Akhmadi14/Terawang/Skematik desain/casing mainboard dan koper alat/tampak samping kanan kotak mainboard.jpg

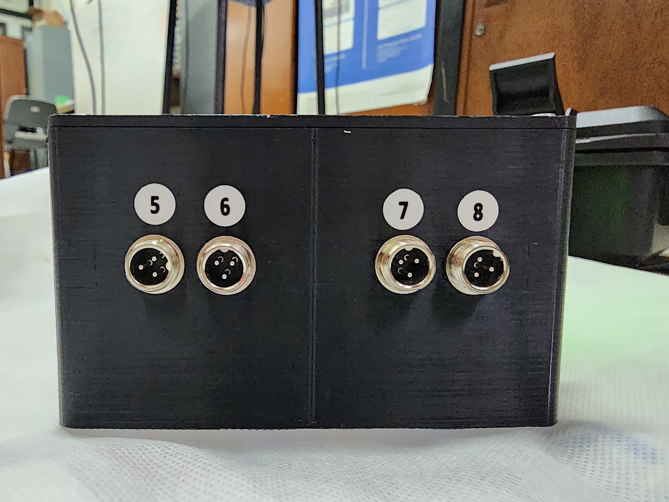
Skematik desain/casing mainboard dan koper alat/tampak samping kanan kotak mainboard.jpg
