Akhmadi14/Terawang/Dokumentasi/IMG_20250317_195810_024.jpg

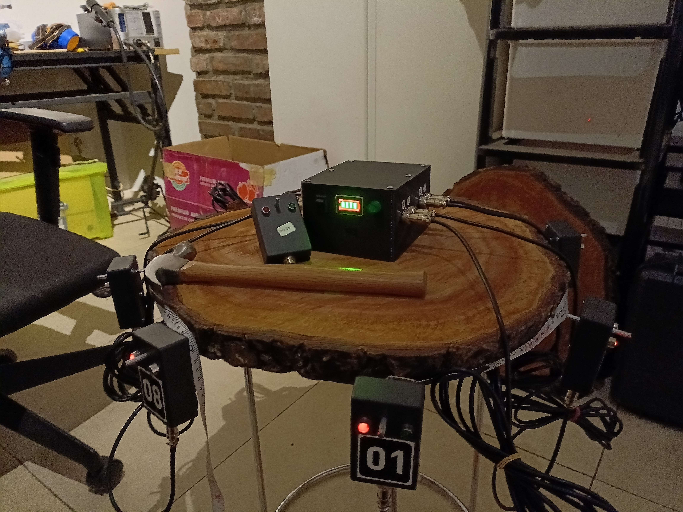
Dokumentasi/IMG_20250317_195810_024.jpg
