Akhmadi14/Terawang/README.md

# Terawang
Engineering Documents for project Terawang
