Akhmadi14/Terawang/Data/Versi_2/README.md

Perhitungan kecepatan dua dilakukan dengan memberikan kompensasi ToF di paku baja.

Penjelasan lebih mendetail bisa dilihat di file velocity_calc2.pdf
