Akhmadi14/Terawang/Data/2. MEDIA KAYU TREMBESI_26_NOV_2024.pdf

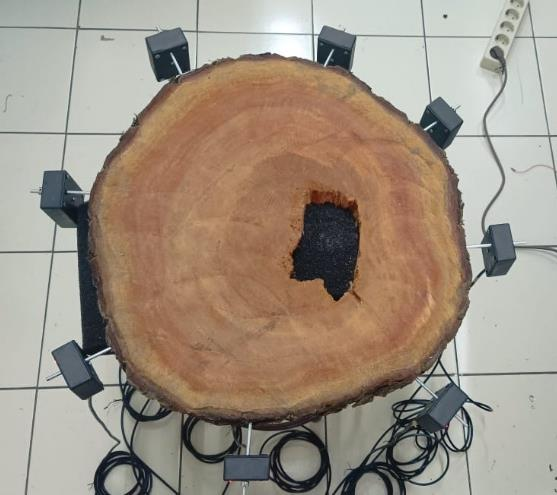
[picture p79: figure]

### PENGUJIAN DENGAN MEDIA UJI

Hari/Tgl | : Selasa, 26 November 2024
Jenis Kayu | : Trembesi
Diameter | : 49,8 cm
Keliling | : 156,7 cm
Keterangan | : -

### PERCOBAAN 1

### Kecepatan Rata-Rata (m/s)

### PERCOBAAN 2

### Kecepatan Rata-Rata (m/s)

### HASIL TOMOGRAFI PERCOBAAN 1

Sensor ke-n | v1 | v2 | v3 | v4 | v5 | v6 | v7 | v8
1 | # | 808 | 1245 | 1078 | 1149 | 797 | 1061 | 726
2 | 821 | # | 885 | 839 | 1110 | 452 | 952 | 942
3 | 1262 | 811 | # | 772 | 1065 | 317 | 987 | 1100
4 | 1622 | 600 | 1557 | # | 1334 | 584 | 1184 | 1322
5 | 1288 | 865 | 1286 | 952 | # | 276 | 955 | 980
6 | 1235 | 804 | 1488 | 1397 | 1310 | # | 1413 | 999
7 | 915 | 713 | 1081 | 862 | 898 | 218 | # | 697
8 | 1096 | 716 | 1404 | 547 | 1059 | 289 | 949 | #
Sensor ke-n | v1 | v2 | v3 | v4 | v5 | v6 | v7 | v8
1 | # | 837 | 1294 | 1220 | 1177 | 326 | 1165 | 686
2 | 861 | # | 898 | 926 | 1120 | 256 | 971 | 815
3 | 1265 | 836 | # | 774 | 1068 | 324 | 1025 | 773
4 | 1565 | 1147 | 1333 | # | 1153 | 261 | 1144 | 1209
5 | 1303 | 1104 | 1296 | 970 | # | 280 | 1027 | 947
6 | 1093 | 587 | 1239 | 1107 | 814 | # | 876 | 726
7 | 829 | 820 | 1091 | 827 | 933 | 200 | # | 675
8 | 1060 | 703 | 1375 | 507 | 1046 | 254 | 931 | #

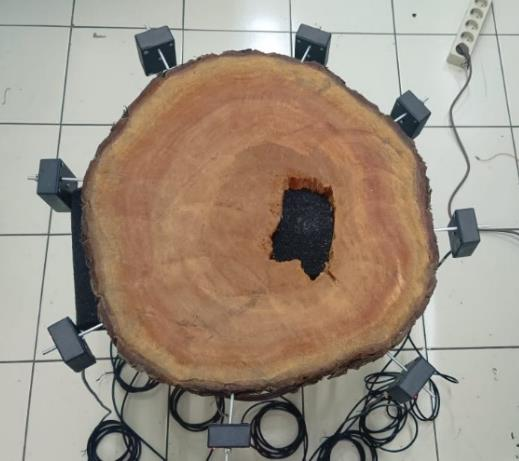
[picture p80: figure]
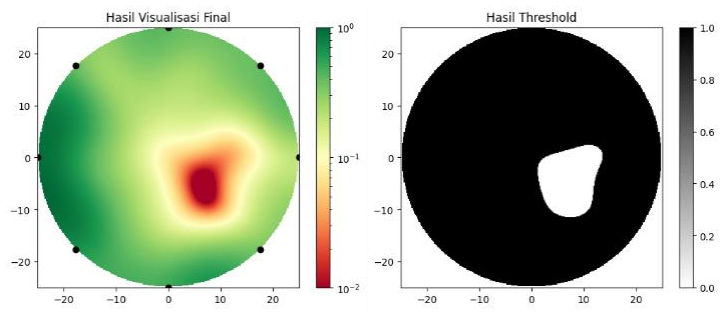
[picture p81: figure]
