Akhmadi14/Terawang/Data/3. POHON HIDUP1_19_DES_2024.pdf

## KAMIS, 19 DESEMBER 2024

Lokasi | : samping Pos Satpam Fakultas SBM

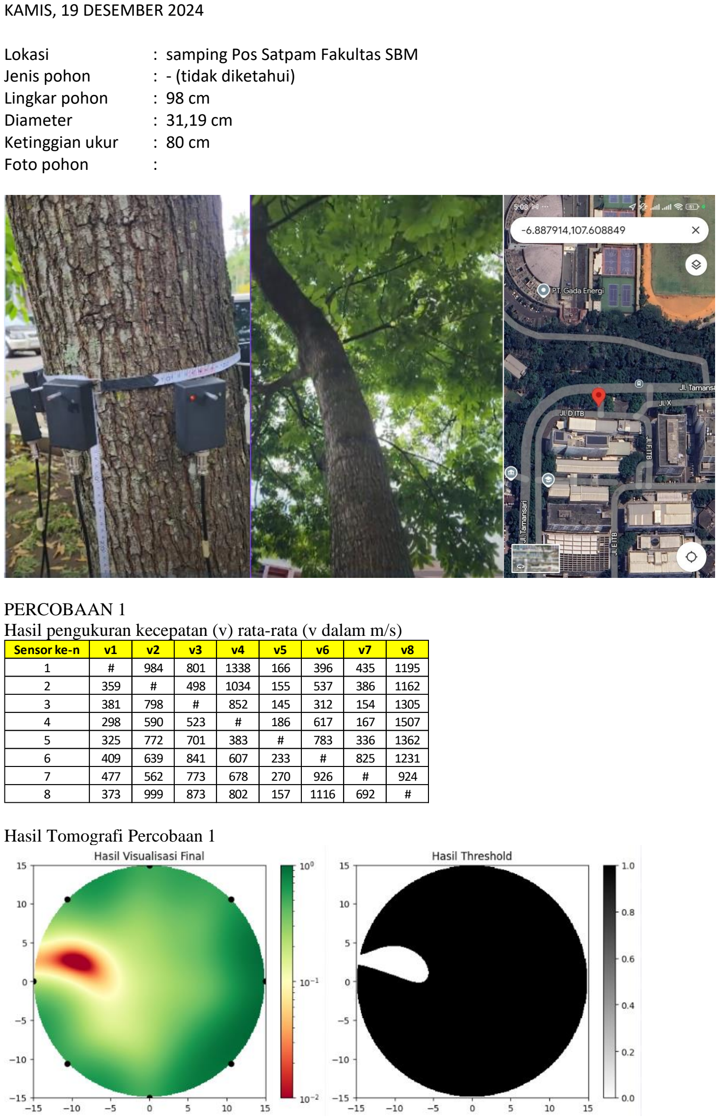
[picture p82: page 1]

Jenis pohon | : - (tidak diketahui)
Lingkar pohon | : 98 cm
Diameter | : 31,19 cm
Ketinggian ukur | : 80 cm
Foto pohon | :

### PERCOBAAN 1 Hasil pengukuran kecepatan (v) rata-rata (v dalam m/s)

### Hasil Tomografi Percobaan 1

Sensor ke-n | v1 | v2 | v3 | v4 | v5 | v6 | v7 | v8
1 | # | 984 | 801 | 1338 | 166 | 396 | 435 | 1195
2 | 359 | # | 498 | 1034 | 155 | 537 | 386 | 1162
3 | 381 | 798 | # | 852 | 145 | 312 | 154 | 1305
4 | 298 | 590 | 523 | # | 186 | 617 | 167 | 1507
5 | 325 | 772 | 701 | 383 | # | 783 | 336 | 1362
6 | 409 | 639 | 841 | 607 | 233 | # | 825 | 1231
7 | 477 | 562 | 773 | 678 | 270 | 926 | # | 924
8 | 373 | 999 | 873 | 802 | 157 | 1116 | 692 | #

### PERCOBAAN 2 Hasil pengukuran kecepatan (v) rata-rata (v dalam m/s)

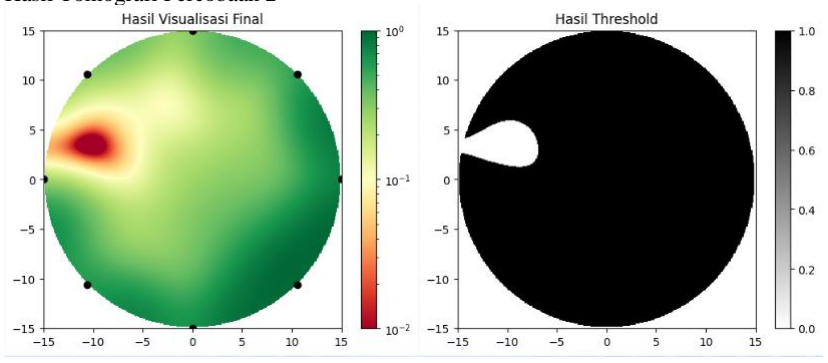
[picture p83: figure]

### Hasil Tomografi Percobaan 2

Sensor ke-n | v1 | v2 | v3 | v4 | v5 | v6 | v7 | v8
1 | # | 897 | 329 | 291 | 166 | 394 | 421 | 1013
2 | 361 | # | 493 | 435 | 103 | 543 | 387 | 1156
3 | 379 | 711 | # | 398 | 147 | 258 | 249 | 1267
4 | 188 | 460 | 495 | # | 82 | 290 | 138 | 1322
5 | 329 | 774 | 700 | 349 | # | 779 | 355 | 1336
6 | 396 | 389 | 691 | 371 | 171 | # | 791 | 1177
7 | 471 | 677 | 345 | 423 | 298 | 898 | # | 906
8 | 374 | 1005 | 613 | 760 | 94 | 1123 | 576 | #
