Akhmadi14/Terawang/Data/4. POHON HIDUP2_19_DES_2024.pdf

## KAMIS, 19 DESEMBER 2024

Lokasi | : belakang gedung fakultas Teknik Mesin

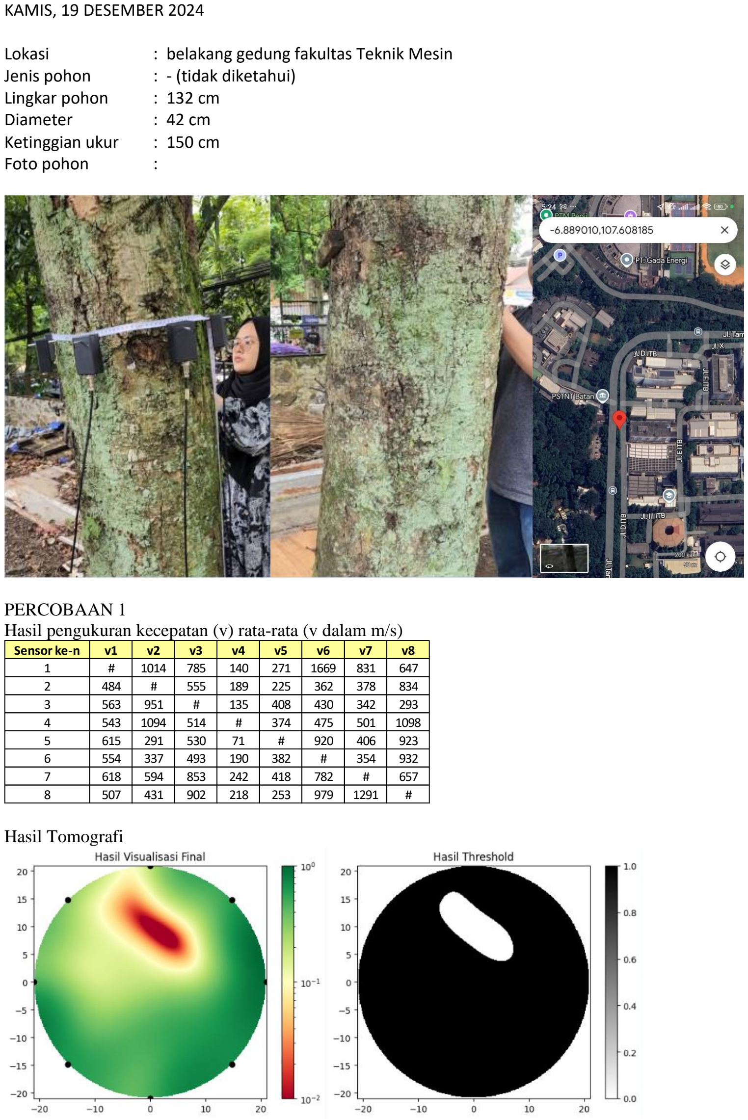
[picture p84: page 1]

Jenis pohon | : - (tidak diketahui)
Lingkar pohon | : 132 cm
Diameter | : 42 cm
Ketinggian ukur | : 150 cm
Foto pohon | :

### PERCOBAAN 1 Hasil pengukuran kecepatan (v) rata-rata (v dalam m/s)

### Hasil Tomografi

Sensor ke-n | v1 | v2 | v3 | v4 | v5 | v6 | v7 | v8
1 | # | 1014 | 785 | 140 | 271 | 1669 | 831 | 647
2 | 484 | # | 555 | 189 | 225 | 362 | 378 | 834
3 | 563 | 951 | # | 135 | 408 | 430 | 342 | 293
4 | 543 | 1094 | 514 | # | 374 | 475 | 501 | 1098
5 | 615 | 291 | 530 | 71 | # | 920 | 406 | 923
6 | 554 | 337 | 493 | 190 | 382 | # | 354 | 932
7 | 618 | 594 | 853 | 242 | 418 | 782 | # | 657
8 | 507 | 431 | 902 | 218 | 253 | 979 | 1291 | #
