Akhmadi14/Terawang/Data/5. POHON HIDUP3_7_JAN_2025.pdf

## SELASA, 7 JANUARI 2025

Lokasi | : Depan Labtek XVII

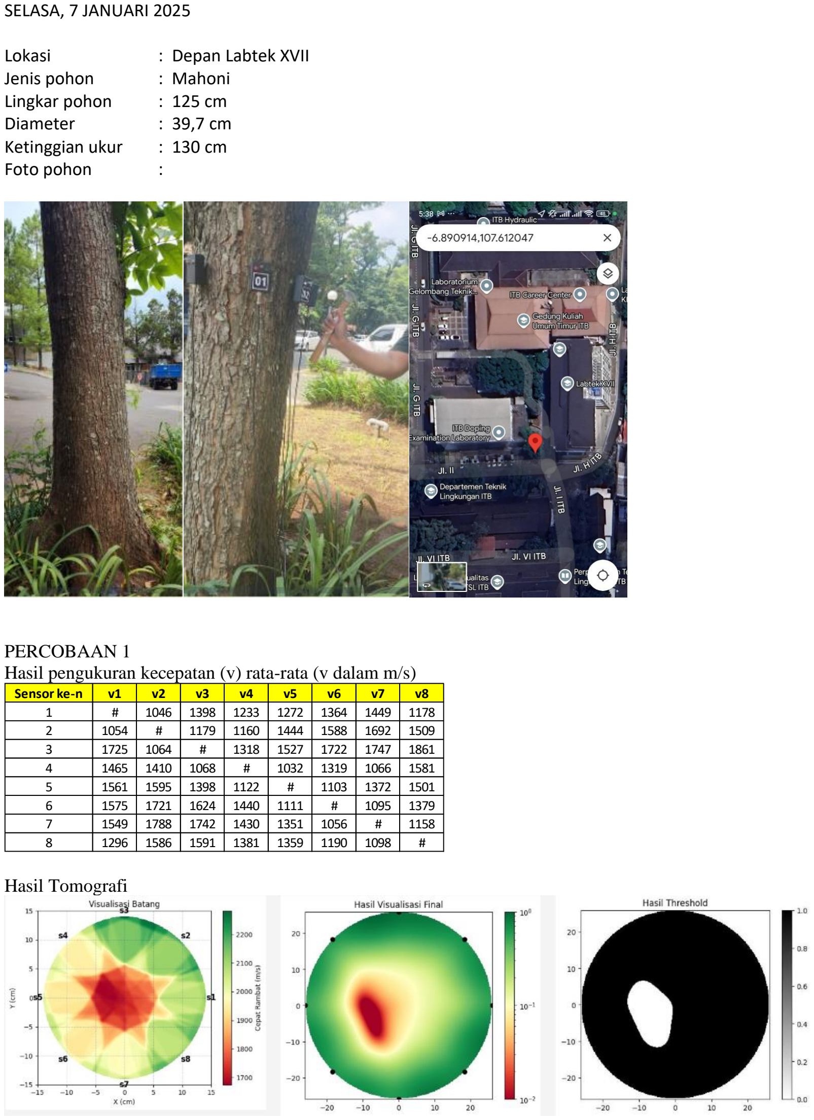
[picture p85: page 1]

Jenis pohon | : Mahoni
Lingkar pohon | : 125 cm
Diameter | : 39,7 cm
Ketinggian ukur | : 130 cm
Foto pohon | :

### PERCOBAAN 1 Hasil pengukuran kecepatan (v) rata-rata (v dalam m/s)

### Hasil Tomografi

Sensor ke-n | v1 | v2 | v3 | v4 | v5 | v6 | v7 | v8
1 | # | 1046 | 1398 | 1233 | 1272 | 1364 | 1449 | 1178
2 | 1054 | # | 1179 | 1160 | 1444 | 1588 | 1692 | 1509
3 | 1725 | 1064 | # | 1318 | 1527 | 1722 | 1747 | 1861
4 | 1465 | 1410 | 1068 | # | 1032 | 1319 | 1066 | 1581
5 | 1561 | 1595 | 1398 | 1122 | # | 1103 | 1372 | 1501
6 | 1575 | 1721 | 1624 | 1440 | 1111 | # | 1095 | 1379
7 | 1549 | 1788 | 1742 | 1430 | 1351 | 1056 | # | 1158
8 | 1296 | 1586 | 1591 | 1381 | 1359 | 1190 | 1098 | #
