Akhmadi14/Terawang/Video/Pengujian/README.md

Video Pengujian di pohon menggunakan Terawang

Video Pengujian berupa link Youtube.
