Akhmadi14/Terawang/Dokumentasi/IMG_20250319_092220_522.jpg

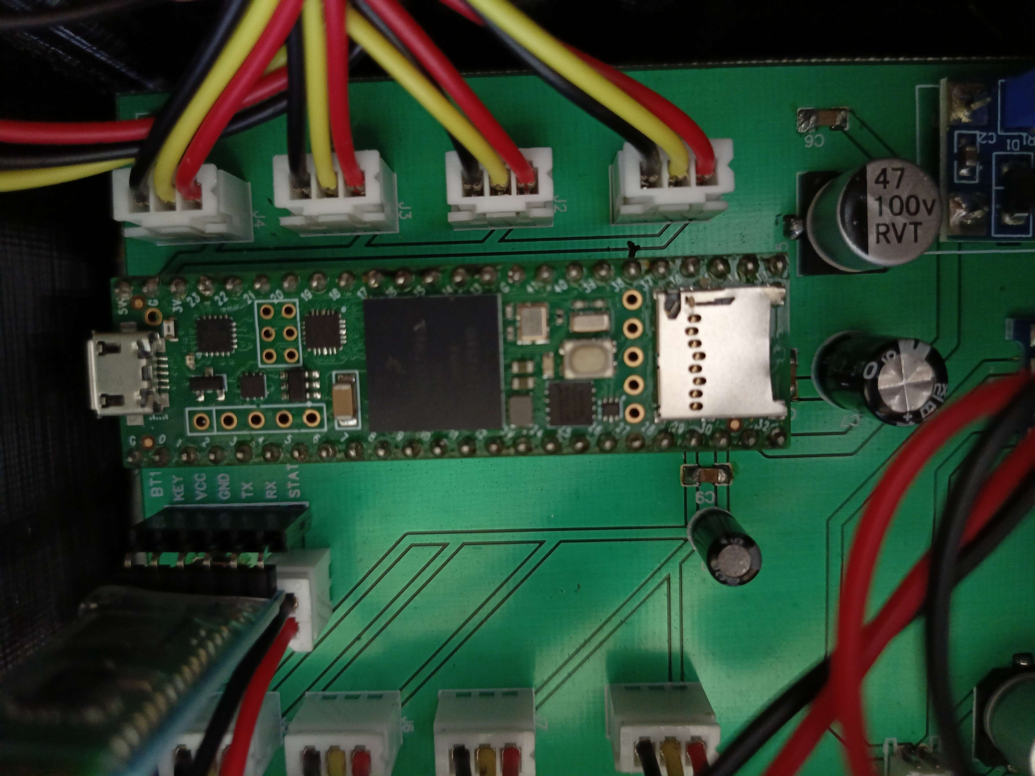
Dokumentasi/IMG_20250319_092220_522.jpg
