Akhmadi14/Terawang/Dokumentasi/IMG_20250319_092229_414.jpg

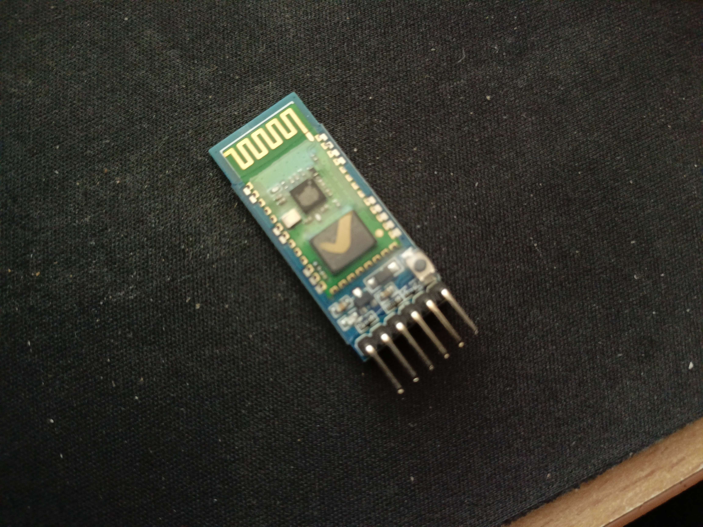
Dokumentasi/IMG_20250319_092229_414.jpg
