Akhmadi14/Terawang/Dokumentasi/IMG_20250319_100055_708.jpg

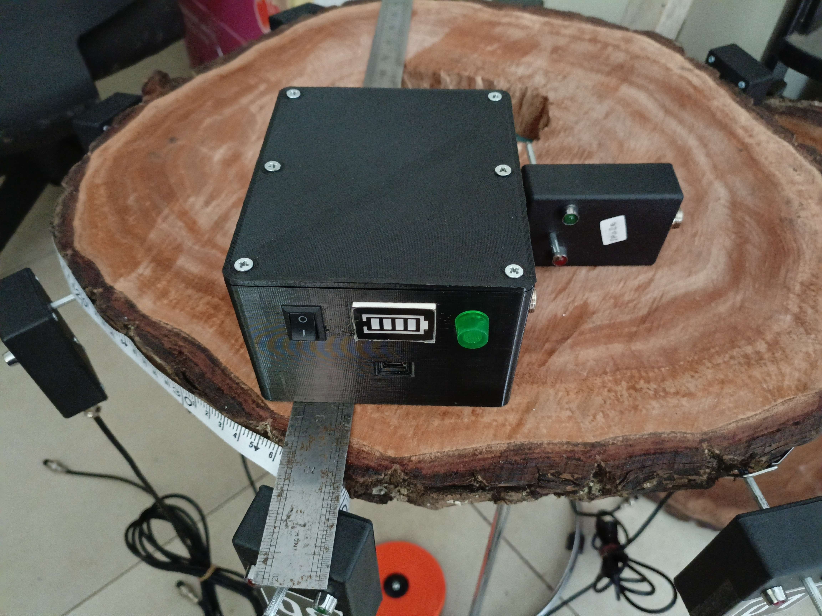
Dokumentasi/IMG_20250319_100055_708.jpg
