Akhmadi14/Terawang/Dokumentasi/WhatsApp Image 2025-03-20 at 09.49.11_72c5101f.jpg

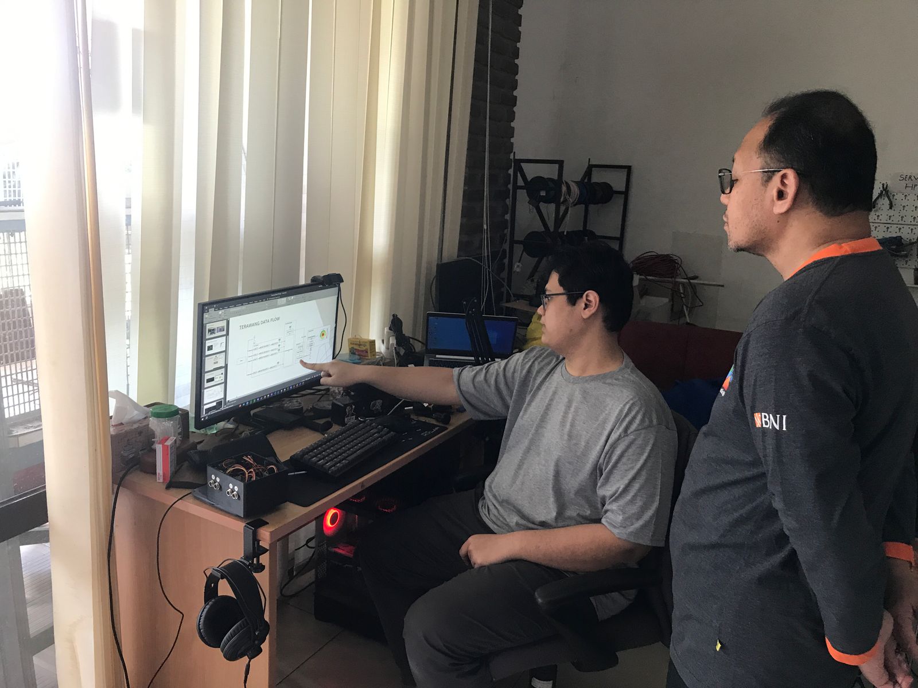
Dokumentasi/WhatsApp Image 2025-03-20 at 09.49.11_72c5101f.jpg
