Akhmadi14/Terawang/Hasil pengukuran/250108/a.png

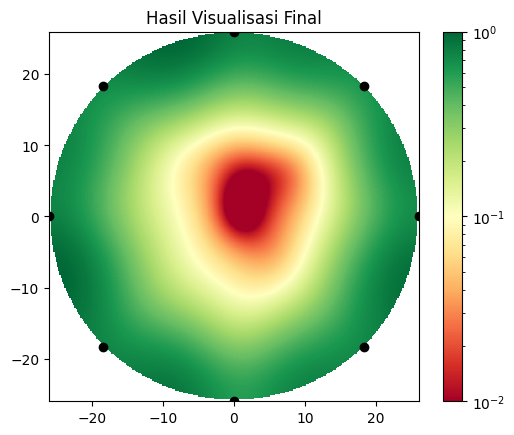
Hasil pengukuran/250108/a.png
