Akhmadi14/Terawang/Hasil pengukuran/250108/b.png

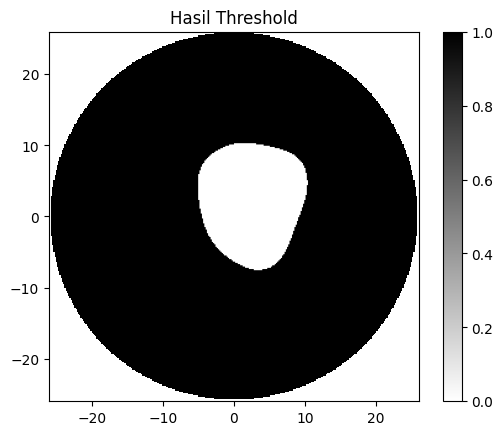
Hasil pengukuran/250108/b.png
