Akhmadi14/Terawang/Hasil pengukuran/pengukuran 1.1/final 1.1.png

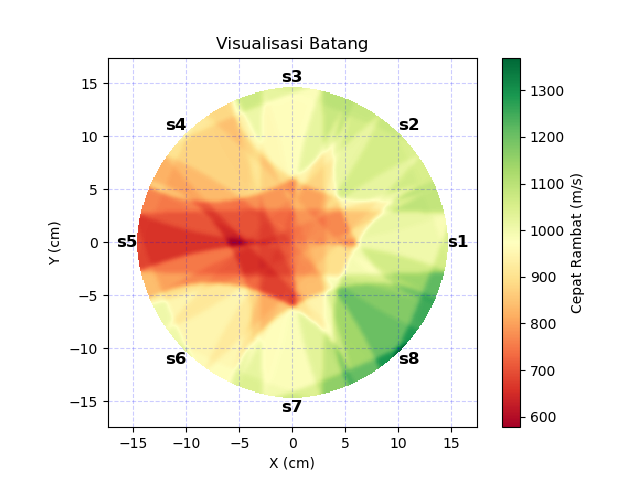
Hasil pengukuran/pengukuran 1.1/final 1.1.png
