Akhmadi14/Terawang/Hasil pengukuran/pengukuran 1.1/th_1.1.png

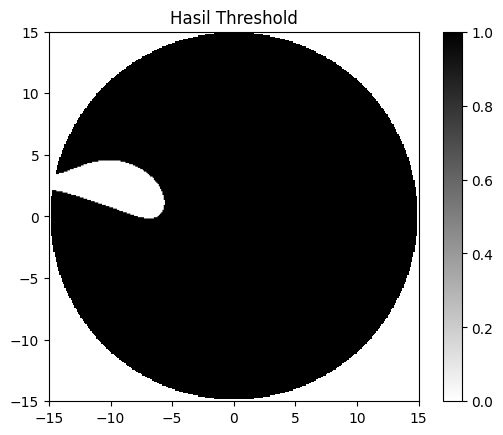
Hasil pengukuran/pengukuran 1.1/th_1.1.png
