Akhmadi14/Terawang/Hasil pengukuran/pengukuran 1.1/visual_1.1.png

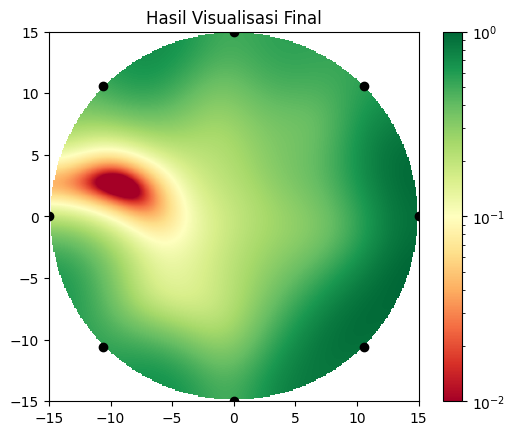
Hasil pengukuran/pengukuran 1.1/visual_1.1.png
