Akhmadi14/Terawang/Hasil pengukuran/pengukuran 1.2/visual_1.2.png

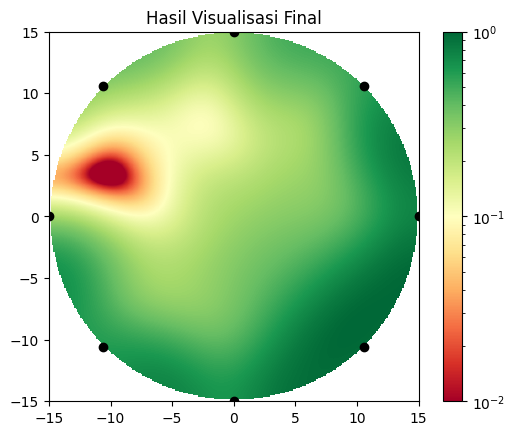
Hasil pengukuran/pengukuran 1.2/visual_1.2.png
