Akhmadi14/Terawang/Hasil pengukuran/pengukuran 2/final 2.png

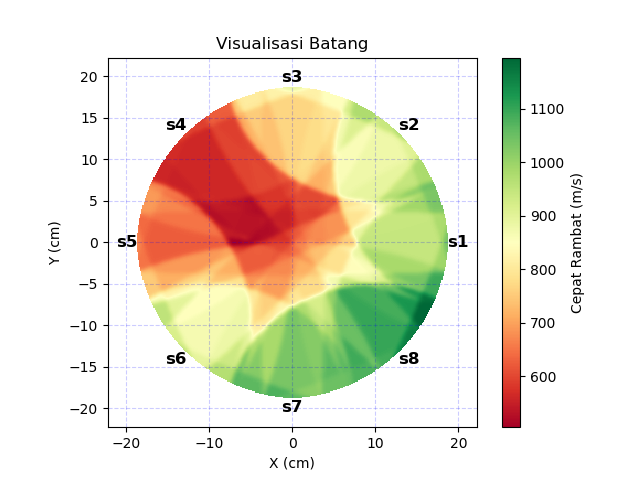
Hasil pengukuran/pengukuran 2/final 2.png
