Akhmadi14/Terawang/Hasil pengukuran/pengukuran 2/th_2.png

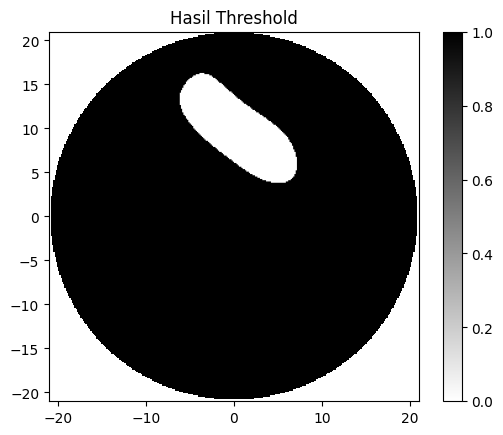
Hasil pengukuran/pengukuran 2/th_2.png
