Akhmadi14/Terawang/Hasil pengukuran/pengukuran 2/visual_2.png

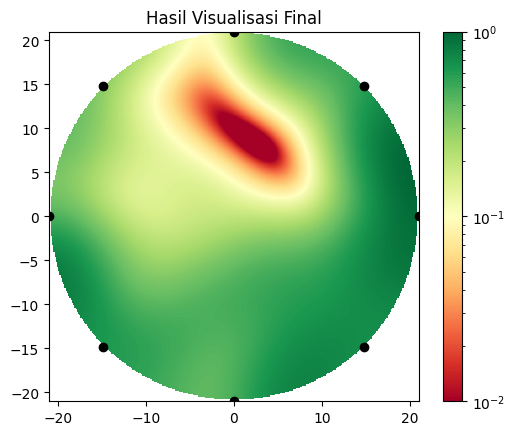
Hasil pengukuran/pengukuran 2/visual_2.png
