Akhmadi14/Terawang/Hasil pengukuran/pengukuran 2/viusal_pohon_basah.png

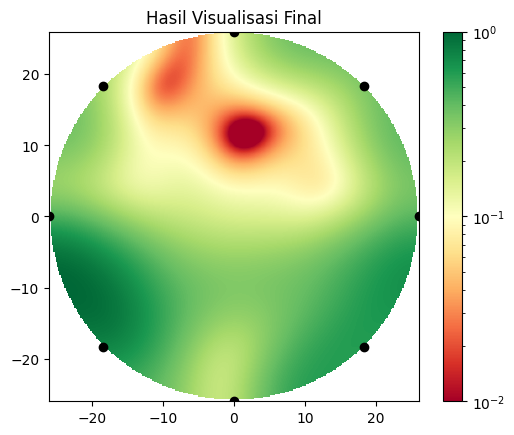
Hasil pengukuran/pengukuran 2/viusal_pohon_basah.png
