Akhmadi14/Terawang/Hasil pengukuran/pengukuran basah/final basah.png

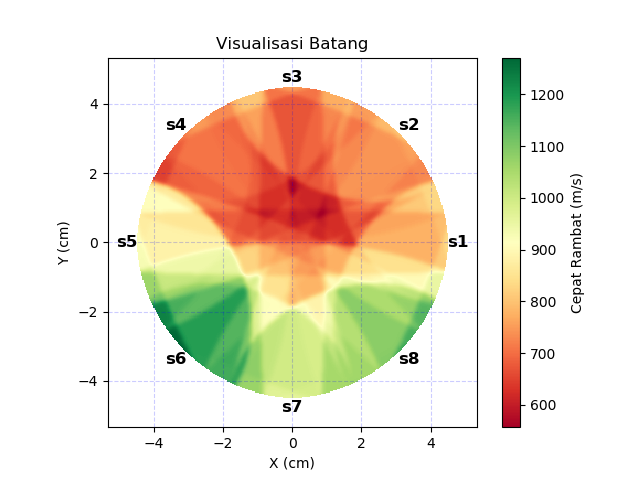
Hasil pengukuran/pengukuran basah/final basah.png
