Akhmadi14/Terawang/Hasil pengukuran/pengukuran basah/LINE_ALBUM_Hasil Pengukuran Pohon Basah 20241220_241226_1.jpg

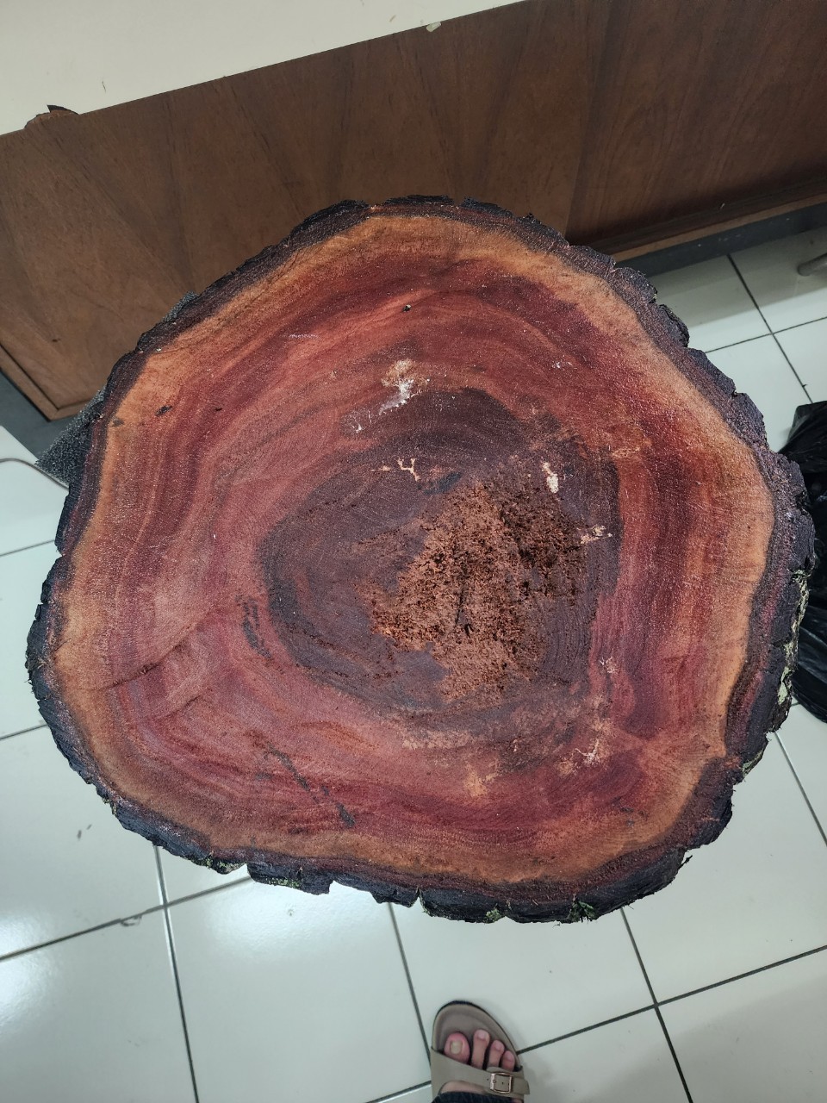
Hasil pengukuran/pengukuran basah/LINE_ALBUM_Hasil Pengukuran Pohon Basah 20241220_241226_1.jpg
