Akhmadi14/Terawang/Hasil pengukuran/pengukuran kering 2/404a2349-3994-4f09-90e3-6211c54b1446.jpg

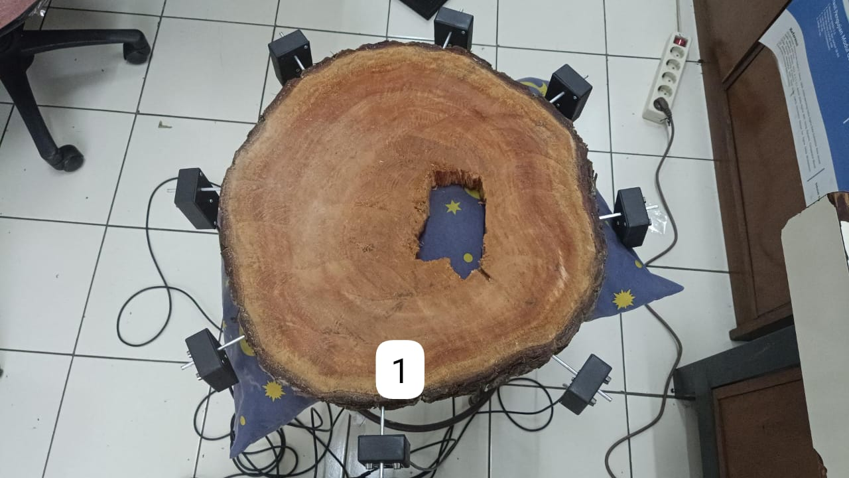
Hasil pengukuran/pengukuran kering 2/404a2349-3994-4f09-90e3-6211c54b1446.jpg
