Akhmadi14/Terawang/Hasil pengukuran/pengukuran kering/final kering.png

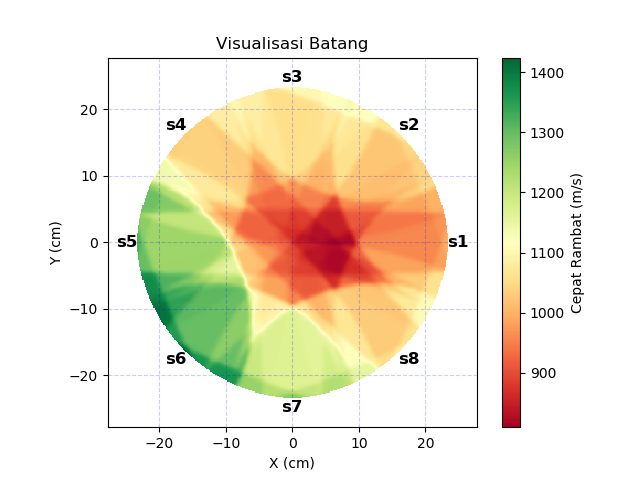
Hasil pengukuran/pengukuran kering/final kering.png
