Akhmadi14/Terawang/Hasil pengukuran/pengukuran kering/LINE_ALBUM_Pohon Kering (sensitivitas lebih tinggi) 20241220_241226_1.jpg

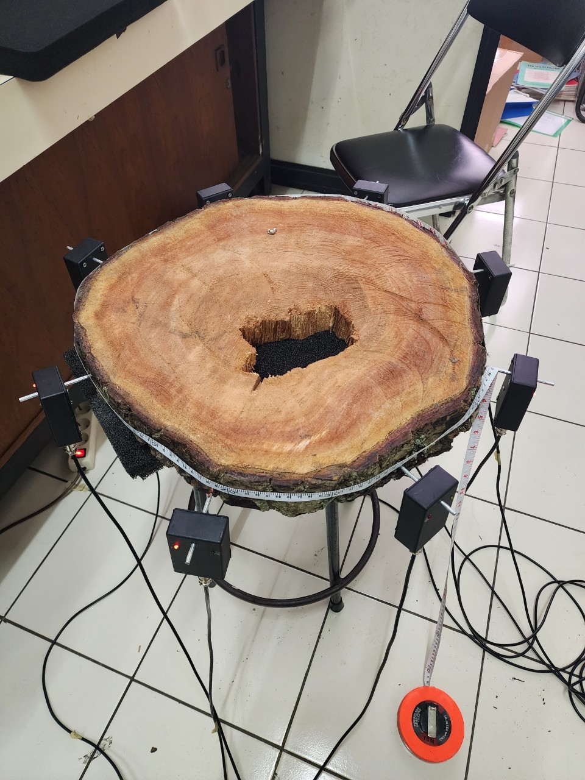
Hasil pengukuran/pengukuran kering/LINE_ALBUM_Pohon Kering (sensitivitas lebih tinggi) 20241220_241226_1.jpg
