Akhmadi14/Terawang/Hasil pengukuran/pengukuran kering/th_kering.png

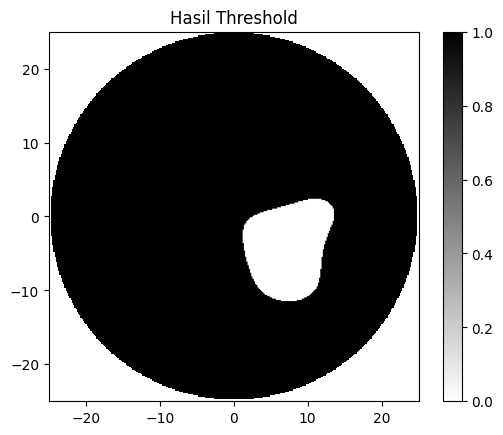
Hasil pengukuran/pengukuran kering/th_kering.png
