Akhmadi14/Terawang/Hasil pengukuran/pengukuran kering/visual_kering.png

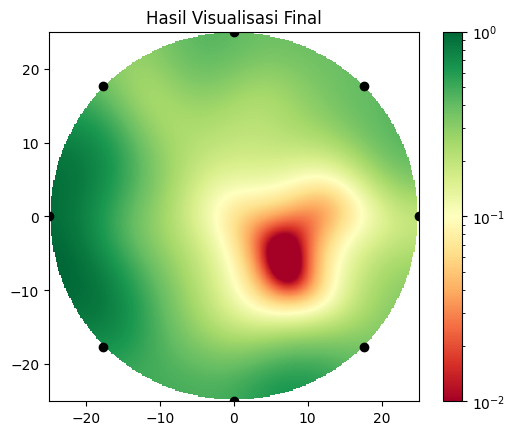
Hasil pengukuran/pengukuran kering/visual_kering.png
