Akhmadi14/Terawang/Hasil pengukuran/pengukuran mahoni gkut/a.png

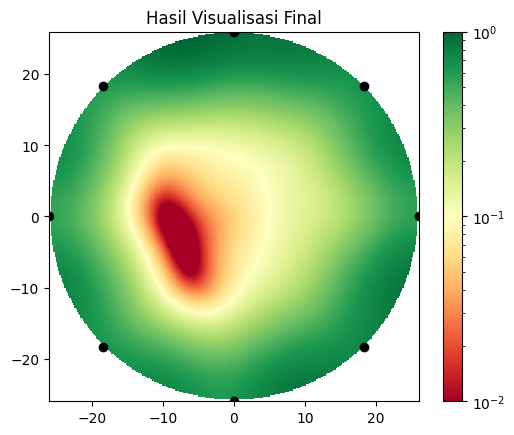
Hasil pengukuran/pengukuran mahoni gkut/a.png
