Akhmadi14/Terawang/Hasil pengukuran/pengukuran mahoni gkut/b.png

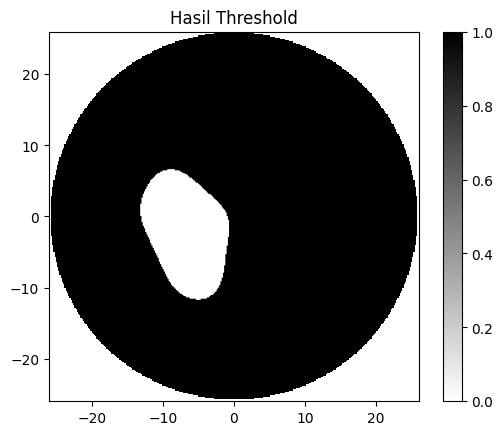
Hasil pengukuran/pengukuran mahoni gkut/b.png
