Akhmadi14/Terawang/Hasil pengukuran/pengukuran mahoni gkut/hasil pengukuran.png

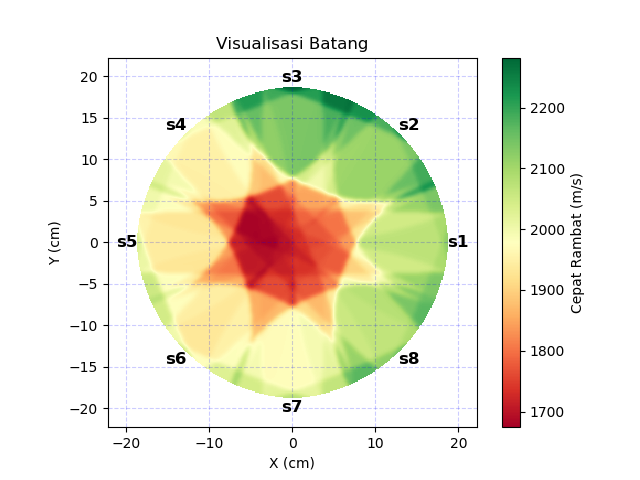
Hasil pengukuran/pengukuran mahoni gkut/hasil pengukuran.png
