Akhmadi14/Terawang/Skematik desain/Arsitektur Utama.png

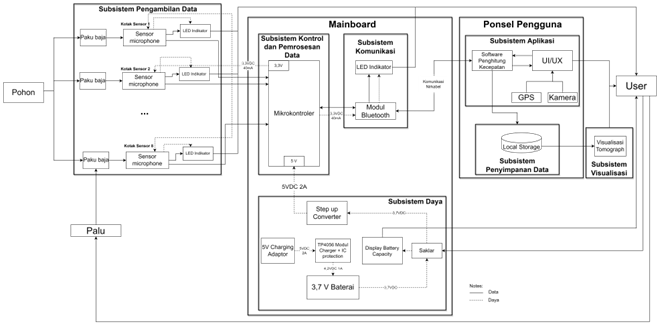
Skematik desain/Arsitektur Utama.png
