Akhmadi14/Terawang/Skematik desain/casing mainboard dan koper alat/cara pemasangan.jpg

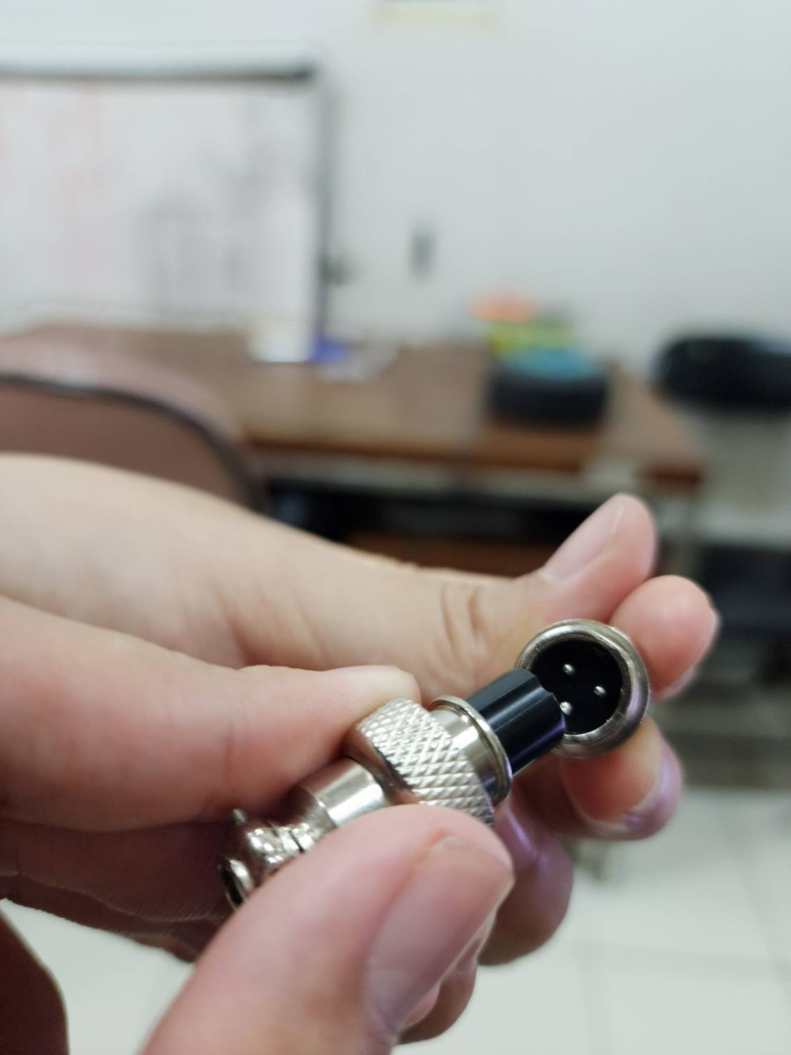
Skematik desain/casing mainboard dan koper alat/cara pemasangan.jpg
