Akhmadi14/Terawang/Skematik desain/casing mainboard dan koper alat/Desain kotak mainboard(isometri).png

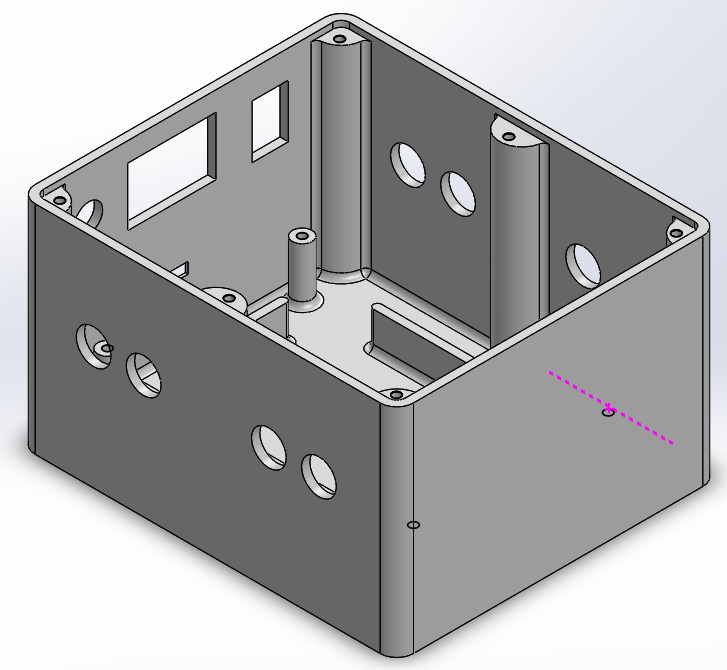
Skematik desain/casing mainboard dan koper alat/Desain kotak mainboard(isometri).png
