Akhmadi14/Terawang/Skematik desain/casing mainboard dan koper alat/hasil modifikasi luggage box1.jpg

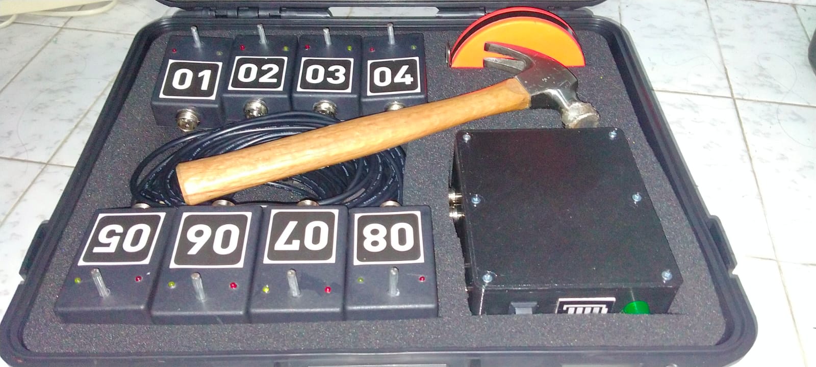
Skematik desain/casing mainboard dan koper alat/hasil modifikasi luggage box1.jpg
