Akhmadi14/Terawang/Skematik desain/casing mainboard dan koper alat/koper alat(Luggage box).png

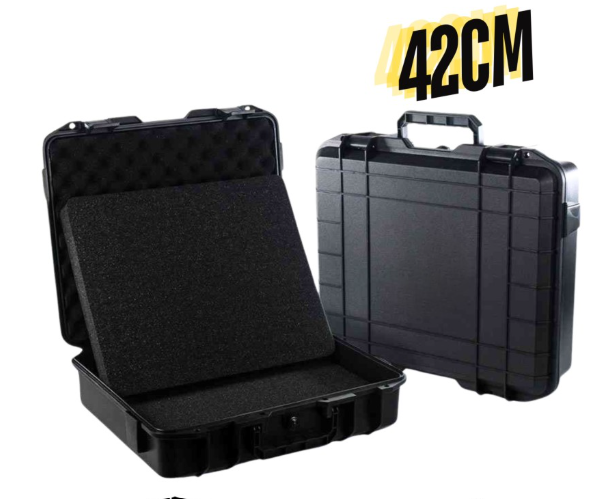
Skematik desain/casing mainboard dan koper alat/koper alat(Luggage box).png
