Akhmadi14/Terawang/Skematik desain/casing mainboard dan koper alat/port kotak mainboard dengan kabel.jpg

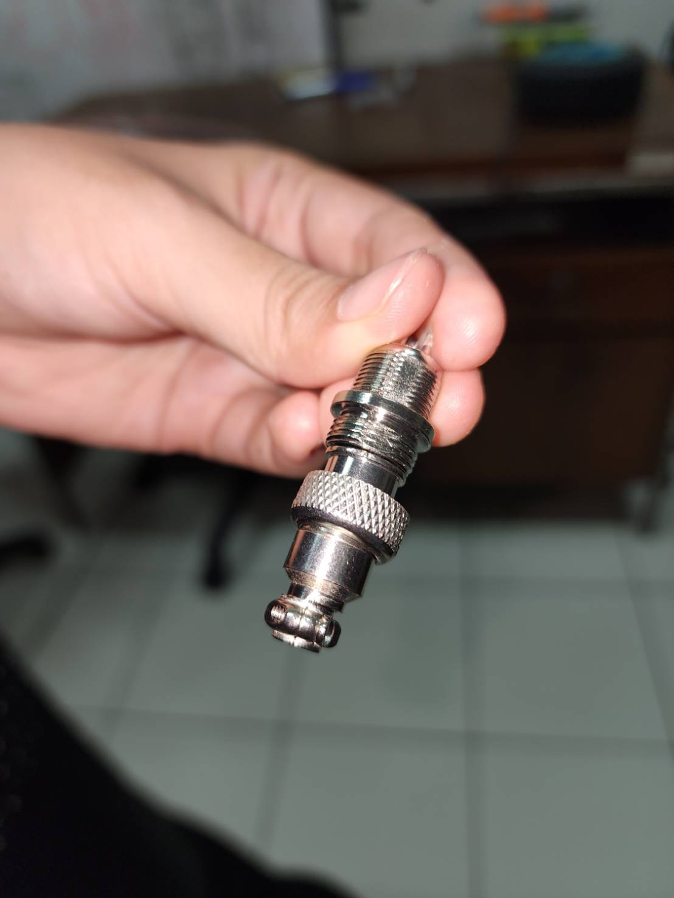
Skematik desain/casing mainboard dan koper alat/port kotak mainboard dengan kabel.jpg
