Akhmadi14/Terawang/Skematik desain/casing mainboard dan koper alat/tampak depan casing mainboard.jpg

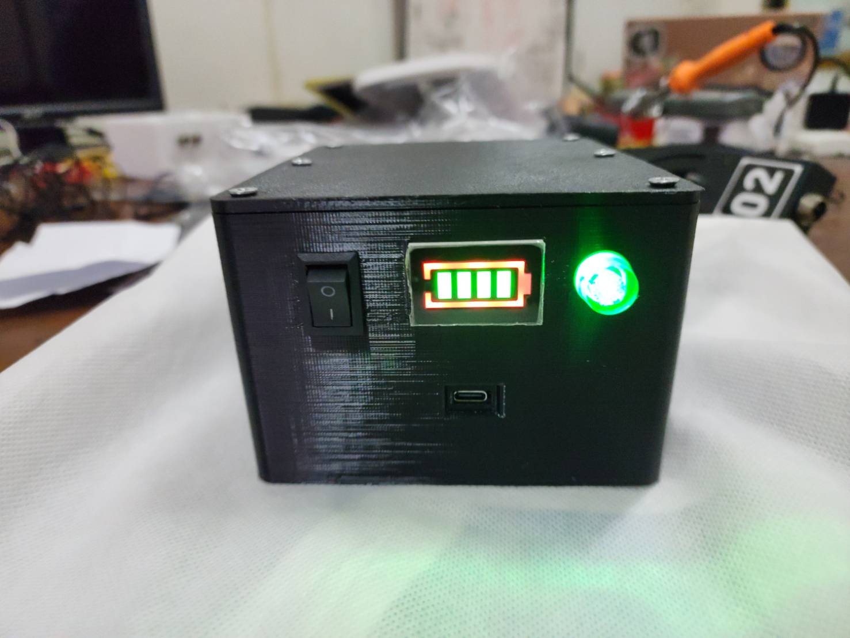
Skematik desain/casing mainboard dan koper alat/tampak depan casing mainboard.jpg
