Akhmadi14/Terawang/Skematik desain/casing mainboard dan koper alat/tampak samping kiri kotak mainboard.jpg

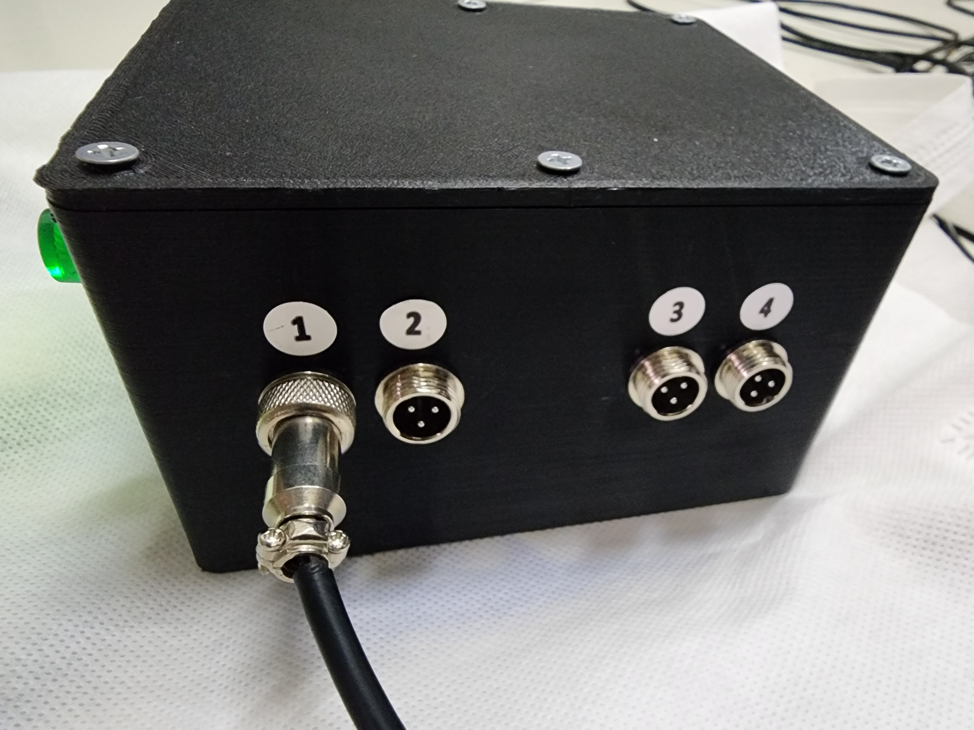
Skematik desain/casing mainboard dan koper alat/tampak samping kiri kotak mainboard.jpg
