Akhmadi14/Terawang/Skematik desain/Gabus Peredam Suara.jpeg

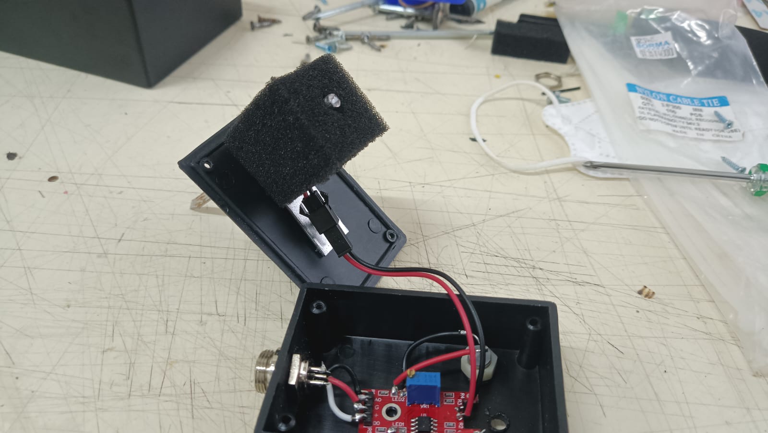
Skematik desain/Gabus Peredam Suara.jpeg
