Akhmadi14/Terawang/Skematik desain/Kondenser KY-037.jpg

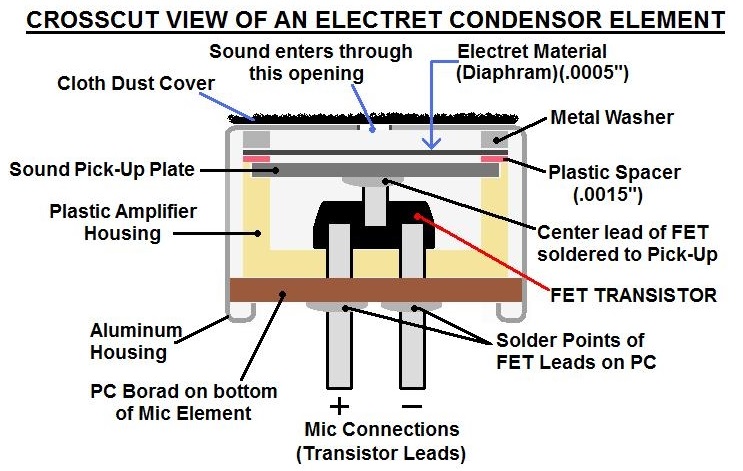
Skematik desain/Kondenser KY-037.jpg
