Akhmadi14/Terawang/Skematik desain/kotak sensor menyala(menerima daya).jpg

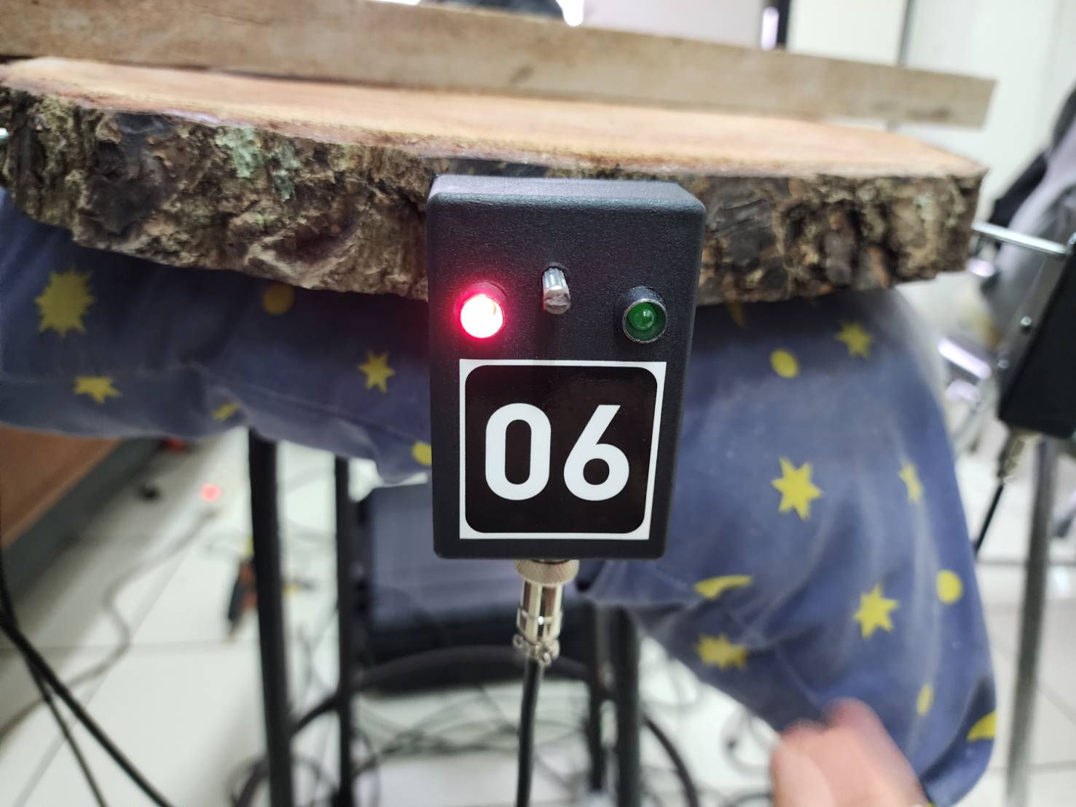
Skematik desain/kotak sensor menyala(menerima daya).jpg
