Akhmadi14/Terawang/Skematik desain/mainboard/PCB Layer atas.png

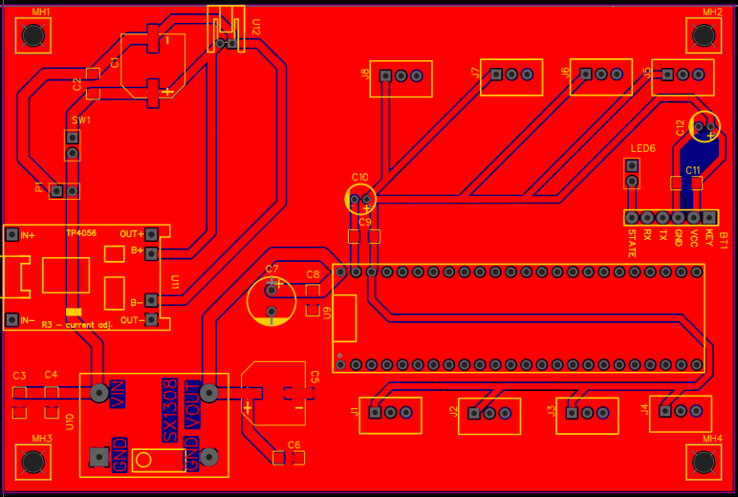
Skematik desain/mainboard/PCB Layer atas.png
