Akhmadi14/Terawang/Skematik desain/mainboard/PCB Layer bawah.png

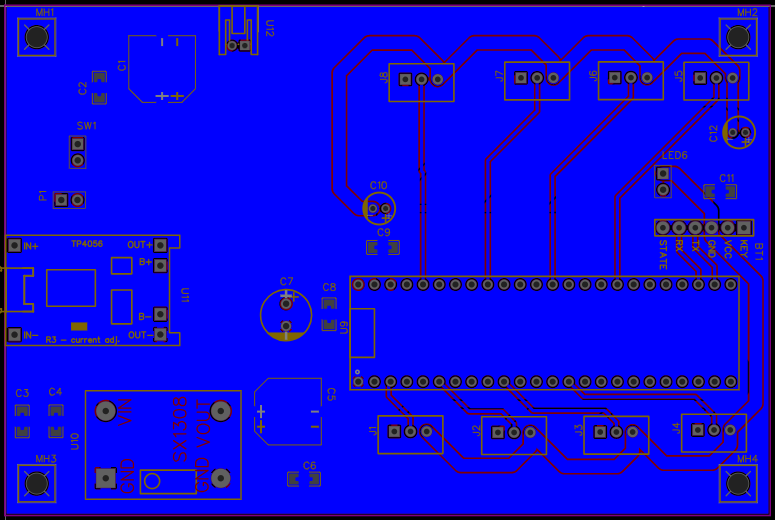
Skematik desain/mainboard/PCB Layer bawah.png
