Akhmadi14/Terawang/Skematik desain/Modifikasi Paku Baja dan Kondenser Mikrofon.jpeg

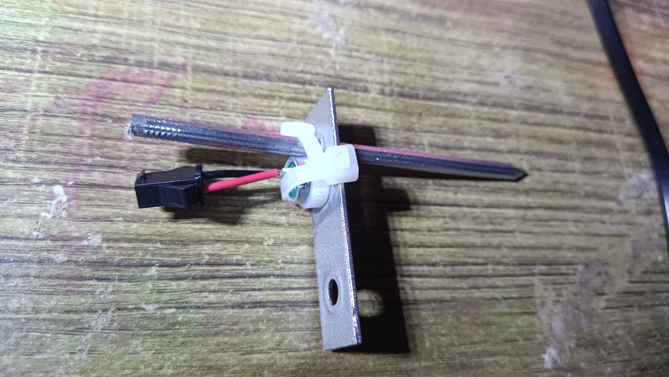
Skematik desain/Modifikasi Paku Baja dan Kondenser Mikrofon.jpeg
