Akhmadi14/Terawang/Skematik desain/Modifikasi Sensor KY037.jpeg

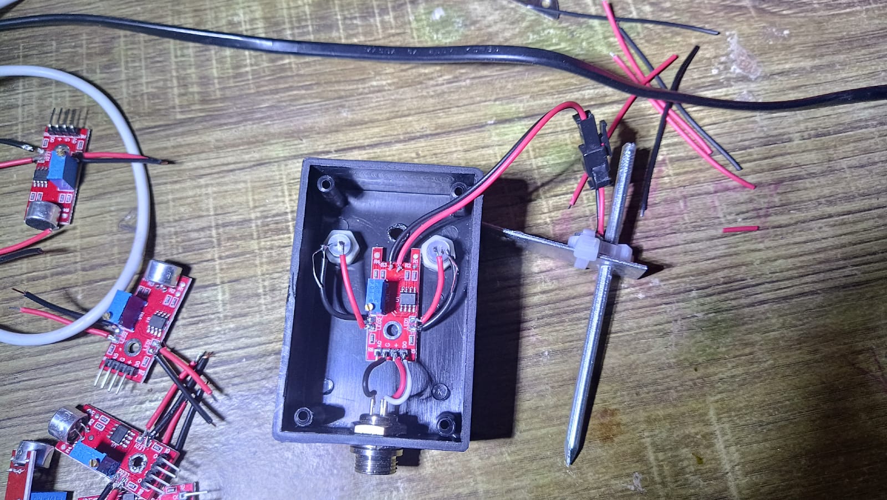
Skematik desain/Modifikasi Sensor KY037.jpeg
