Akhmadi14/Terawang/Skematik desain/posisi palu saat mengetuk sensor.jpg

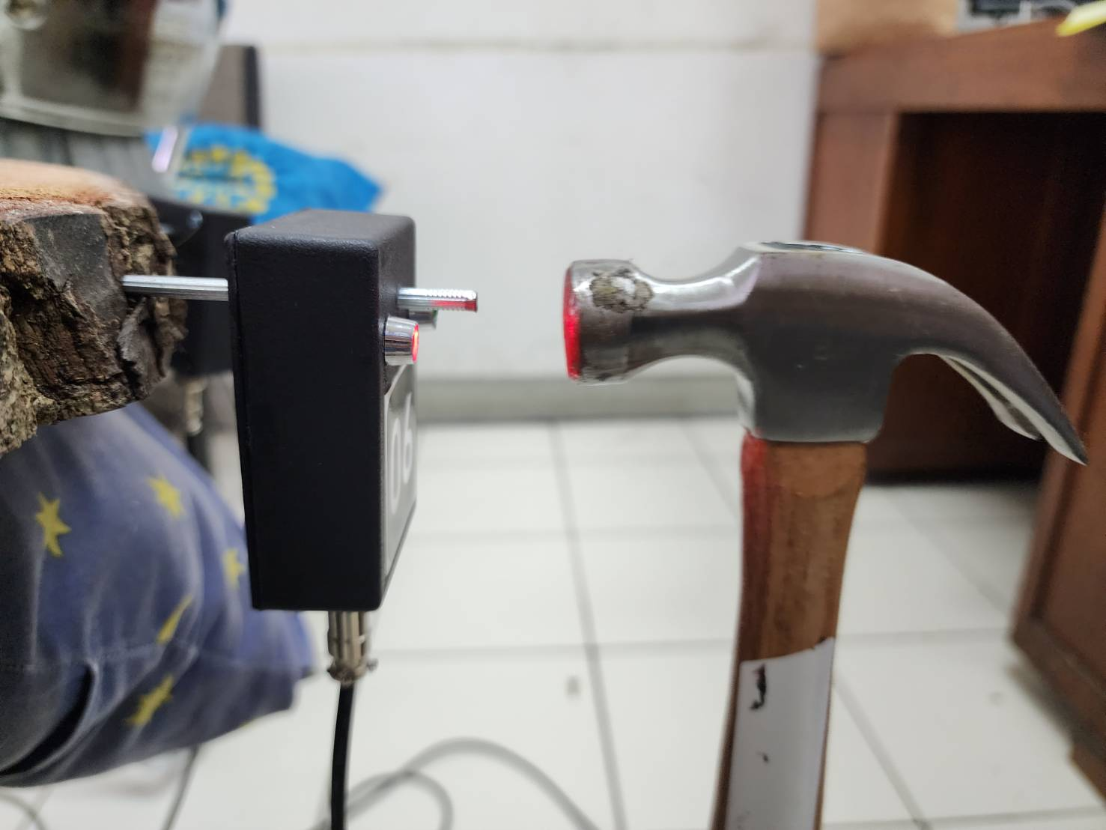
Skematik desain/posisi palu saat mengetuk sensor.jpg
