Akhmadi14/Terawang/Skematik desain/posisi tangan saat melepaskan kotak sensor.jpg

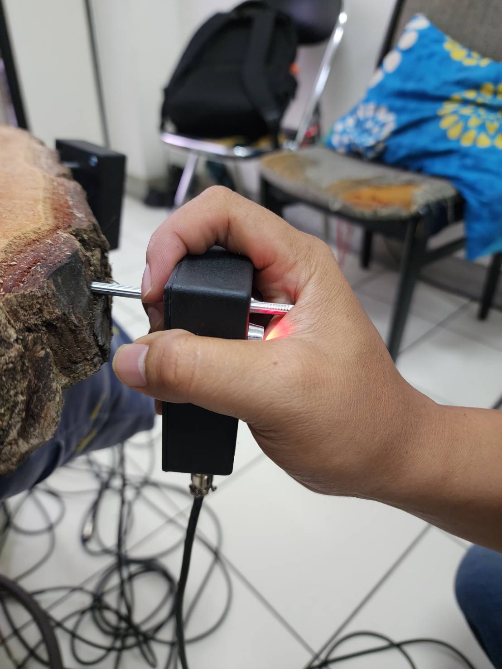
Skematik desain/posisi tangan saat melepaskan kotak sensor.jpg
