Akhmadi14/Terawang/Skematik desain/sensor KY-037.jpg

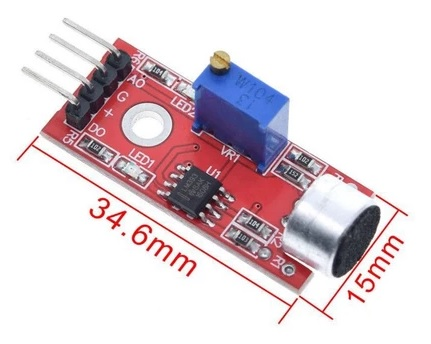
Skematik desain/sensor KY-037.jpg
