Akhmadi14/Terawang/Skematik desain/sinyal diterima oleh sensor.jpg

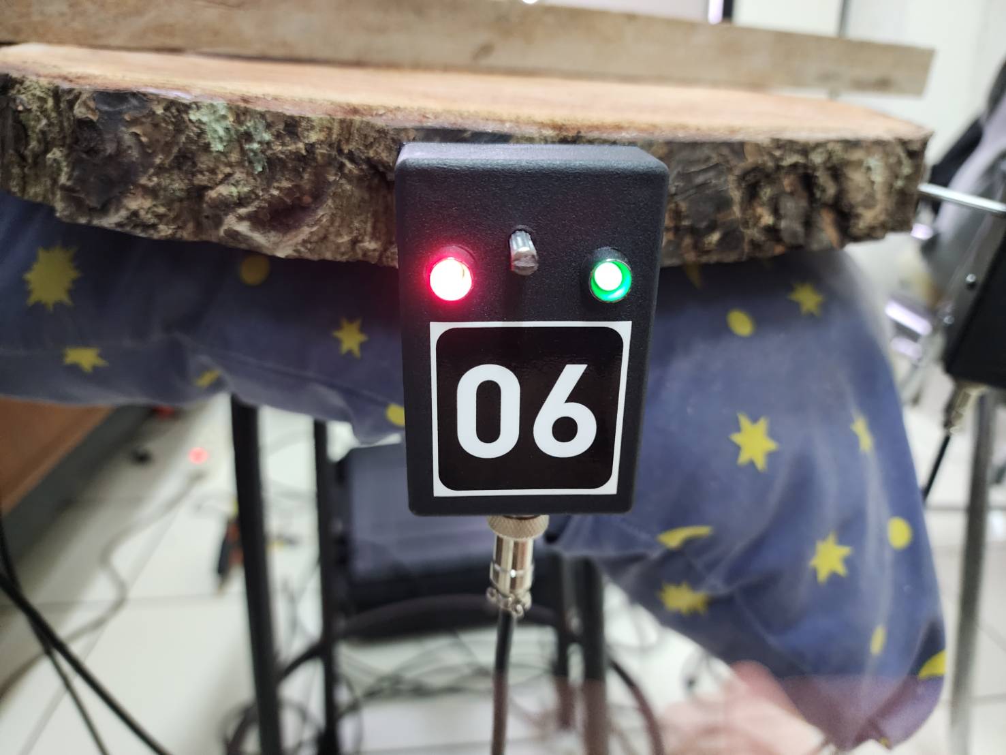
Skematik desain/sinyal diterima oleh sensor.jpg
