Akhmadi14/Terawang/Skematik desain/Skematik KY-037.jpg

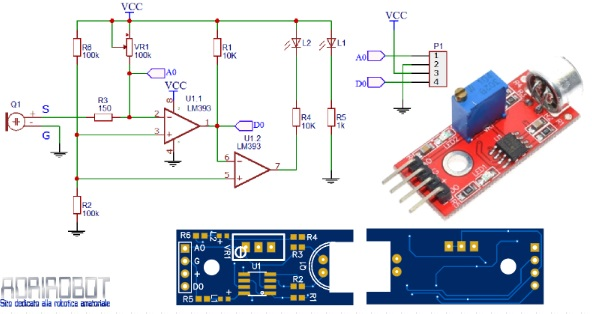
Skematik desain/Skematik KY-037.jpg
