Akhmadi14/Terawang/Skematik desain/Skematik Mikrokontroler.png

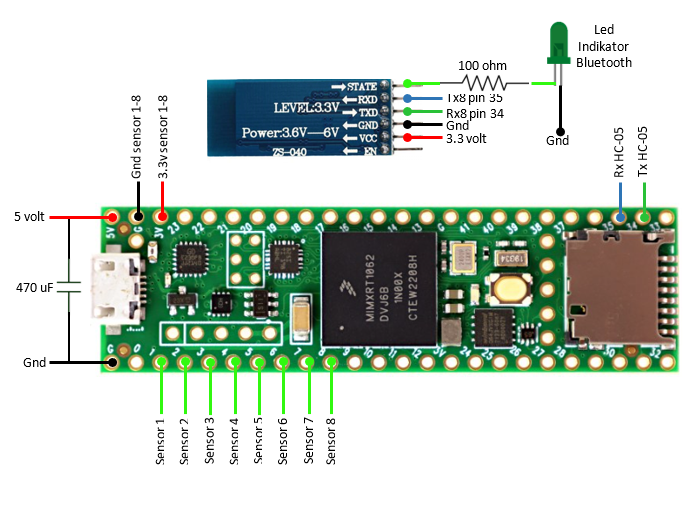
Skematik desain/Skematik Mikrokontroler.png
