Akhmadi14/Terawang/Bill of Materials/BILL OF MATERIAL.xlsx

Harga Material Alat TERAWANG (Monitoring Kondisi Internal Batang Pohon mengggunakan Acoustic Tomography)
SUB SISTEM | KOMPONEN | JUMLAH |  | HARGA SATUAN | TOTAL | VENDOR
Data Akuisisi | Paku Baja 10 cm | 8 | pcs | Rp 8000 | Rp 64000
 | Lempeng Besi 15mm x 40mm | 8 | pcs | Rp 3000 | Rp 24000
 | Las Kuningan | 8 | pcs | Rp 7500 | Rp 60000
 | Sensor KY-037 | 8 | pcs | Rp 7500 | Rp 60000
 | Led merah | 8 | pcs | Rp 500 | Rp 4000
 | Led Hijau | 8 | pcs | Rp 500 | Rp 4000
 | Bracket Led | 16 | pcs |  | Rp 0
 | Kotak Sensor | 8 | pcs | Rp 3500 | Rp 28000
 | Kabel Jumper Vcc | 1 | mtr | Rp 3000 | Rp 3000
 | Kabel Jumper Gnd | 1 | mtr | Rp 3000 | Rp 3000
 | Kabel Jumper D0 | 1 | mtr | Rp 3000 | Rp 3000
 | Konektor 2 pin M-F | 8 | pcs |  | Rp 0
 | Sekrup Kotak Sensor | 32 | pcs | Rp 500 | Rp 16000
 | Mur Baut | 8 | pcs |  | Rp 0
 | GX12 Jack Aviation Plug Socket M-F,3P | 8 | pcs | Rp 9000 | Rp 72000
 | Kabel data 3 core | 24 | mtr | Rp 9000 | Rp 216000
 | Shaft Drill Locator Stop Collars 5mm hole | 8 | pcs | Rp 4500 | Rp 36000
 | Stiker Angka Waterproof 4cm (kotak sensor) | 8 | pcs | Rp 340 | Rp 2720 | RELOAD STICKER (Shopee)
Kontrol dan Pemrosesan Data | Teensy 4.1 | 1 | pcs | Rp 830000 | Rp 830000
Komunikasi Nirkabel | Bluetooth HC-05 | 1 | pcs | Rp 55000 | Rp 55000
 | Resistor 100 ohm | 1 | pcs | Rp 500 | Rp 500
 | Pilot Lamp LED 12V DC Plastik Bening Power I ndicator Signal Light XD10-3 HIJAU | 1 | pcs | Rp 2190 | Rp 2190 | BEST A&Y (Shopee)
Casing dan Daya | PCB | 1 | pcs | Rp 114000 | Rp 114000 | Spectra (081572493433)
 | 3D Printing | 1 | pcs | Rp 267000 | Rp 267000 | SnoveLab (085862026925)
 | Koper Mini Hardcase Multifungsi Case with Sponge Precut Foam ABS Box - 42CM | 1 | pcs | 249000 | Rp 249000 | BSO Tactical (Tokopedia)
 | 1260110 Baterai Li-Po 10000mah | 1 | pcs | Rp 152000 | Rp 152000 | Lind Store (Tokopedia)
 | TP4056 + BMS 5V USB TYPE-C 1A LITHIUM BATTERY CHARGING + PROTECTION MODULE | 1 | pcs | Rp 5900 | Rp 5900 | CNC STORE BANDUNG (Shopee)
 | SX1308 STEP UP CONVERTER BOOST MODULE ADJUSTABLE | 1 | pcs | Rp 4900 | Rp 4900
 | PIN HEADER FEMALE STRIP SINGLE ROW 1X40 2.54MM BLACK HITAM | 3 | pcs | Rp 1200 | Rp 3600
 | LITHIUM BATTERY FUEL GAUGE DISPLAY MODULE 1/2/3/4/6/7/8S GREEN | 1 | pcs | Rp 15900 | Rp 15900
 | CAPACITOR ELECTROLYTIC ELCO KAPASITOR ELEKTROLIT ELKO 470UF 470UF/25V | 1 | pcs | Rp 600 | Rp 600
 | 100nF ±20% 50V X7R 1206 | 6 | pcs | Rp 250 | Rp 1500 | Lisu Instrument (Shopee)
 | 22uF ±10% 25V X5R 1206 | 1 | pcs | Rp 1399 | Rp 1399
 | 10uF 50V Electrolytic Capacitor | 2 | pcs | Rp 1399 | Rp 2798
 | 47uF 100V ±20% 10x10.2mm SMD Aluminum Electrolytic Capacitors | 1 | pcs | Rp 5299 | Rp 5299
 | 50V 220UF SMD ELCO(10*10.2MM) | 1 | pcs | Rp 2500 | Rp 2500 | Jogjarobotika (Tokopedia)
 | Connector Konektor JST PH2.0 Male Right angle Siku L Bengkok for Lipo baterai | 1 | pcs | Rp 150 | Rp 150 | Aladin Shop (Shopee)
 | Connector JST XH2.54 2Pin Male | 3 | pcs | Rp 600 | Rp 1800
 | Connector JST XH2.54 3Pin XH Male | 8 | pcs | Rp 600 | Rp 4800
 | Kabel konektor JST XH XH2.5 3P | 8 | pcs | Rp 1400 | Rp 11200
 | Kabel JST XH XH2.5 2P | 3 | pcs | Rp 1300 | Rp 3900
 | GX12 Jack Aviation Plug Socket Male,3Pin | 8 | pcs | Rp 4500 | Rp 36000 | Tenako Electric (Shopee)
 | GX12 Jack Aviation Plug Socket Female,3Pin | 8 | pcs | Rp 4500 | Rp 36000
 | STIKER ANGKA BULAT 1 CM WATERPROOF | 1 | pcs | Rp 9500 | Rp 9500 | ANIMO LABEL (Shopee)
 | Meteran Gulung Roll Kain 10M | 1 | pcs | Rp 14850 | Rp 14850 | OTENTIK TEKNIK (Shopee)
 | Palu kambing gagang kayu | 1 | pcs | Rp 35000 | Rp 35000
 |  |  |  | Total Harga | Rp 2463006
