Akhmadi14/Terawang/Skematik desain/casing mainboard dan koper alat/penutup casing_Revisi.SLDPRT

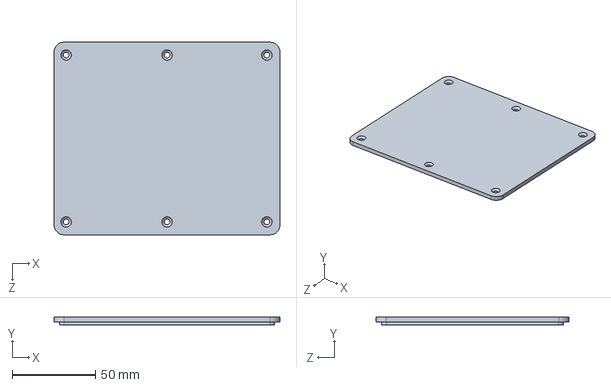
[picture p335: CAD file, 2025-01-23]
Skematik desain/casing mainboard dan koper alat/penutup casing_Revisi.SLDPRT
136.0 x 5.00 x 116.0 mm
