Akhmadi14/Terawang/Skematik desain/casing mainboard dan koper alat/casing utama_Revisi.SLDPRT

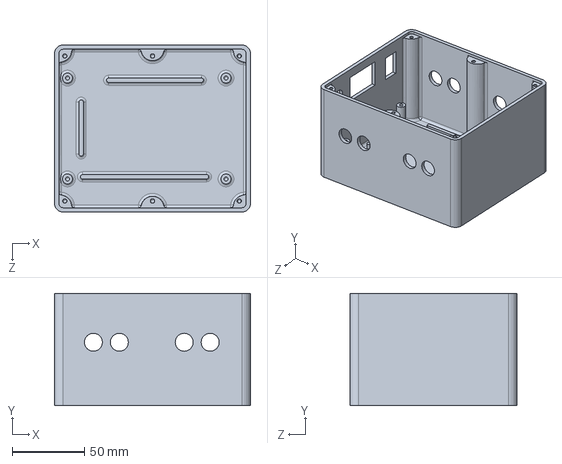
[picture p336: CAD file, 2025-01-23]
Skematik desain/casing mainboard dan koper alat/casing utama_Revisi.SLDPRT
136.0 x 78.0 x 116.0 mm
