Akhmadi14/Terawang/(list of files, cad)

Other CAD files:
Skematik desain/casing mainboard dan koper alat/casing utama_Revisi.STL
Skematik desain/casing mainboard dan koper alat/penutup casing_Revisi.STL
