Akhmadi14/Terawang/Skematik desain/mainboard/Gerber_PCB-Maiboard-2025-01-21/How-to-order-PCB.txt

How to Order PCB

Please refer to:
https://docs.easyeda.com/en/PCB/Order-PCB
