Akhmadi14/Terawang/Data/LOGBOOK SENSOR ADXL335_.pdf

KABEL SENSOR

Panjang : 3 meter

Cek V awal = 3.3 V (mikon)

Cek V akhir = 3.315 V (multimeter

CARA MENDAPATKAN ToF DENGAN ADXL335

1. Perubahan nilai analog akselerasi keluaran pin dibaca dengan analogRead(PIN). Nilai berkisar Nilai akselerasi Y saat diam (-g) = 265-270

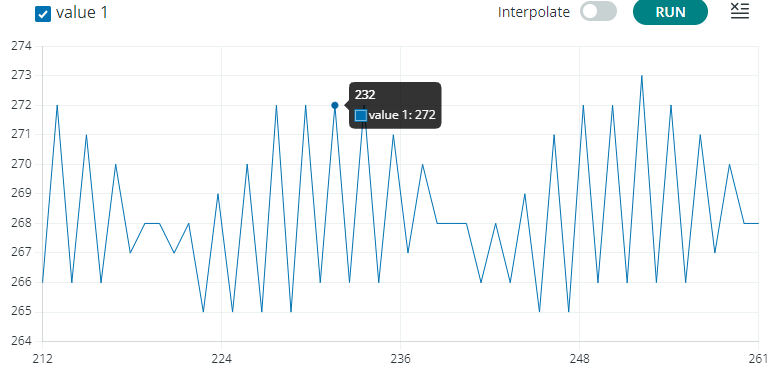
[picture p337: figure]

Saat dipukul | = 250-290

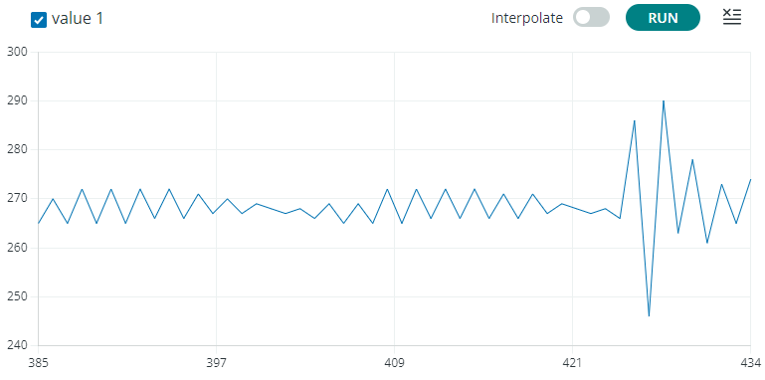
[picture p338: figure]

Cara dapatkan Tof dgn tresshold

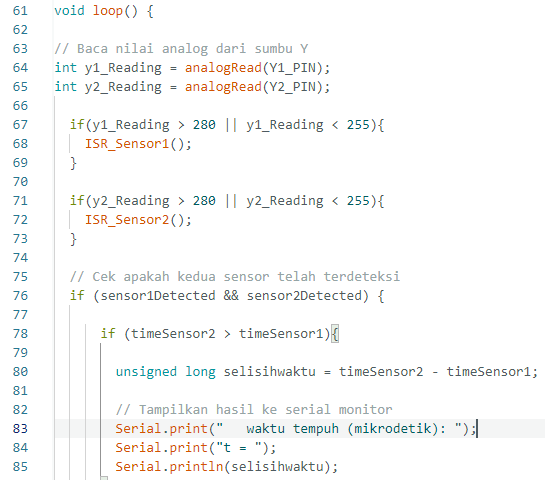
[picture p339: figure]

Hasil tidak valid

gravitasi

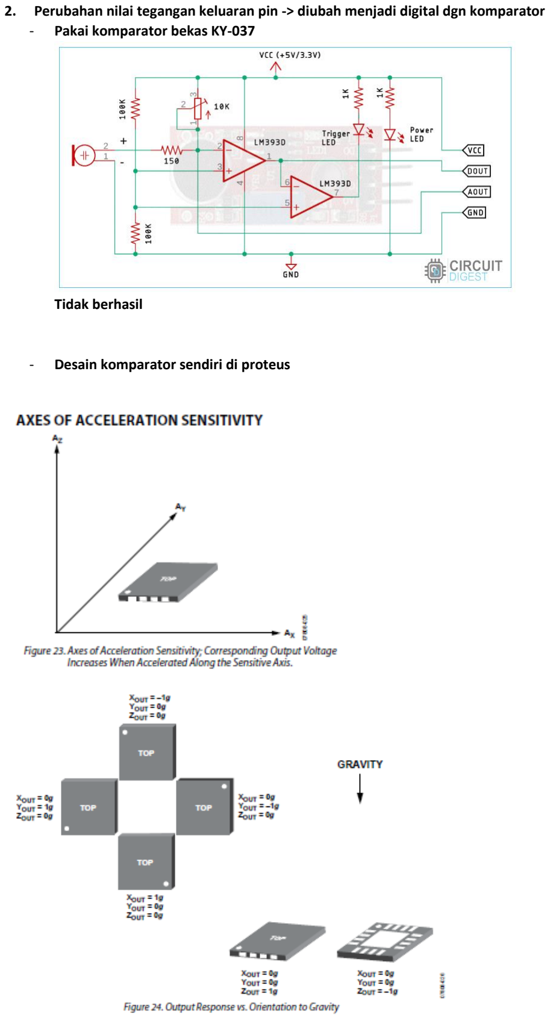
[picture p340: page 2]

### 2. Perubahan nilai tegangan keluaran pin -> diubah menjadi digital dgn komparator

- Pakai komparator bekas KY-037

Tidak berhasil

- Desain komparator sendiri di proteus

KARAKTERISTIK SENSOR PIN Y

KARAKTERISTIK | -G | +G
Pengaruh Gravitasi Saat Diam gravitasi | Analog out Pin Y = 265-270 V out = 1.301 V | Analog out Pin Y = 395-400 V out = 1.941 V
Ketika mendapat akselerasi se arah gravitasi (ke bawah) | V > 1.301 Volt | V > 1.941 Volt
Ketika mendapat akselerasi melawan gravitasi (ke atas) | V < 1.301 Volt | V < 1.941 Volt
Ketika dipukul dari ujung lain | V kadang naik 1.321 Volt tp lebih sering tidak berubah | V kadang naik 1.314 Volt tp lebih sering tidak berubah

KARAKTERISTIK SENSOR PIN Z

KARAKTERISTIK | Zero G
Pengaruh Gravitasi Saat Diam gravitasi | Analog out Pin Y = 332 V out = 1.627 V
Ketika dipukul dari ujung lain | Perubahan sangat kecil hanya mencapai 1.656 V dan lebih sering tidak naik

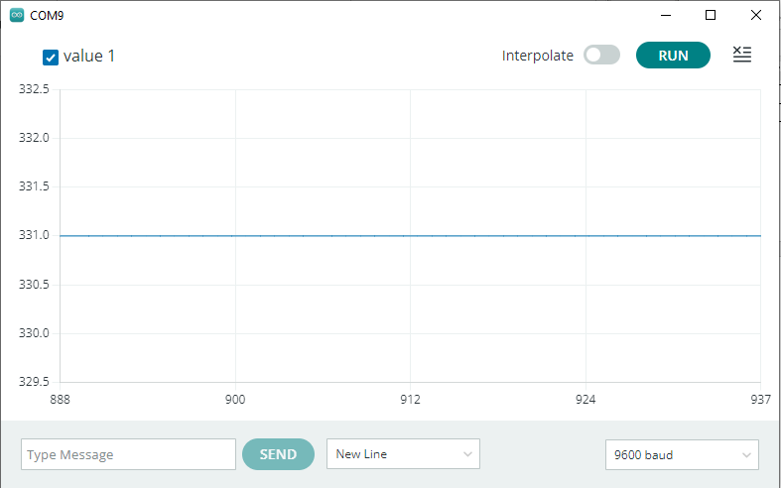
[picture p341: figure]

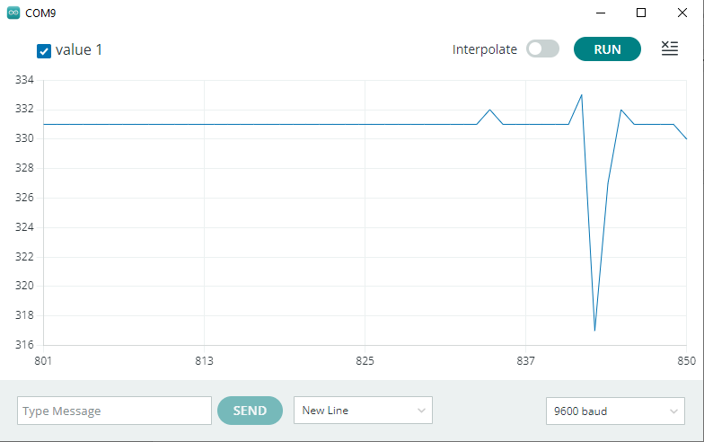
[picture p342: figure]
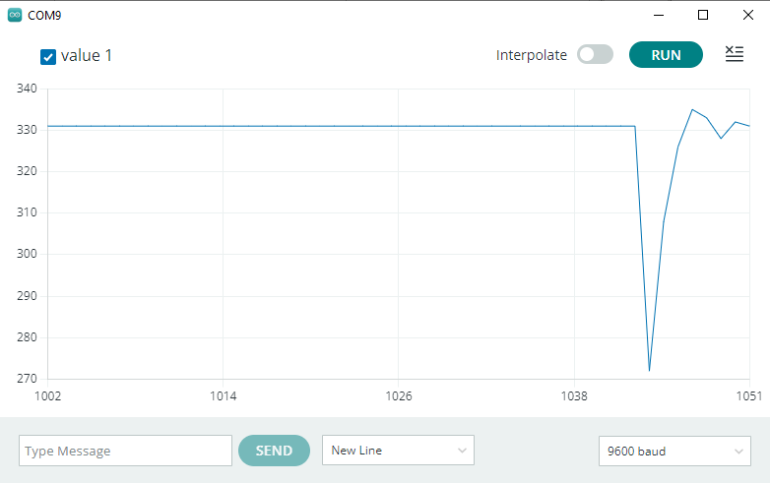
[picture p343: figure]
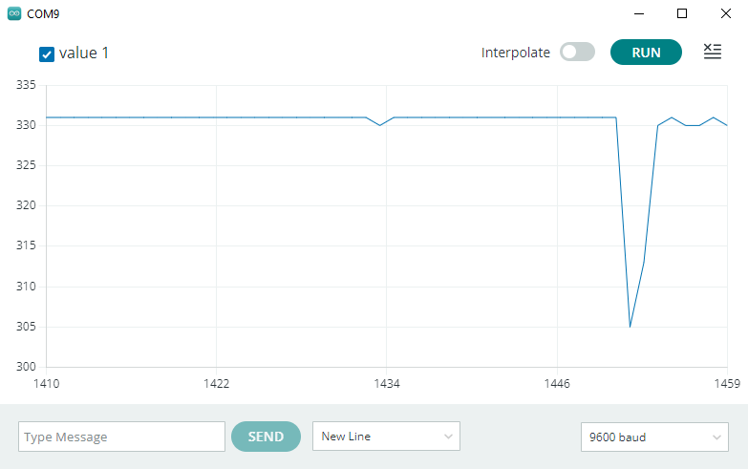
[picture p344: figure]
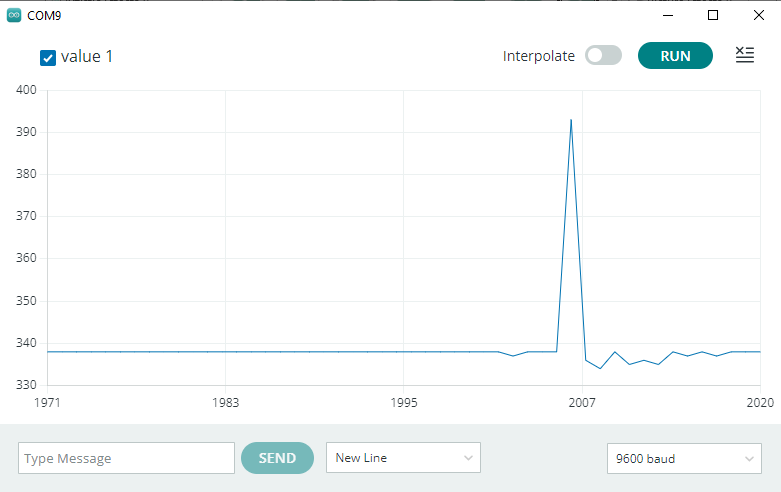
[picture p345: figure]

PERCOBAAN DENGAN PEMROSESAN SINYAL SENSOR ADXL335

Fungsi Rangkaian :

Differensial Amplifier : Vout sb. Y adxl335 pada posisi tegak dan diam adalah ± 1,315 V. Berdasarkan pengamatan dengan multimeter, ketika kayu dipukul oleh palu, tegangan bertambah +0,020. Sehingga untuk mengetahui perubahan tegangan tersebut digunakan rangkaian pengurang tegangan (diff amp). Jika langsung menggunakan amplifier penguat tanpa dikurangi terlebih dahulu, maka tegangan tersebut akan menjadi sangat besar dan melebihi tegangan operasi Teensy 4.1 (3,3V). Jika dikurangi terlebih dahulu lalu diberikan penguat amplifier, maka hasil penguatan tersebut masih masuk pada tegangan operasi Teensy 4.1.

Op. Amplifier | : sebagai penguat tegangan sehingga perubahan tegangan yang kecil dalam skala milivolt masih dapat diketahui.
Komparator | : Memberikan threshold pada perubahan nilai tegangan sehingga ketika melebihi nilai threshold akan dibaca sebagai logika HIGH atau 1. Sebaliknya jika tegangan dibawah nilai threshold maka akan dibaca sebagai nilai LOW atau 0.

Output Sensor → Diff Op Amp → Amplifier → Komparator

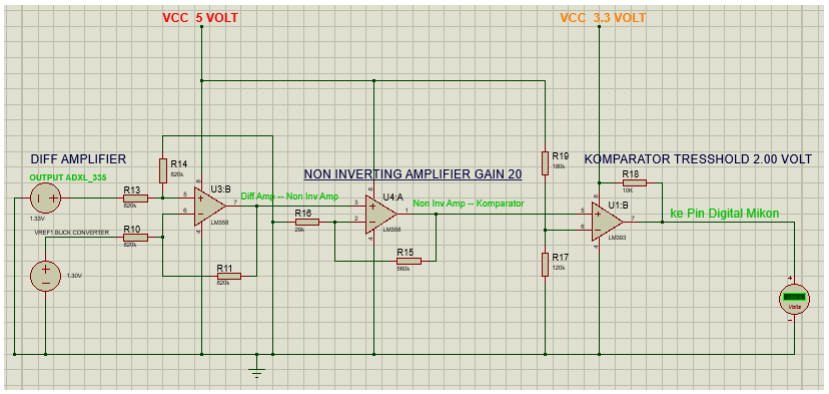
[picture p346: figure]

Ideal:

1.316 volt – 1.230 volt = 0.086 volt * 20 = 1.720 volt

Real:

1.290 volt – 1.210 volt ≈ 0.082 volt * 20 ≈ 1,623 volt (diam) ketika dipukul < 2 volt → 0

Ketika dipukul > 2 volt → 1

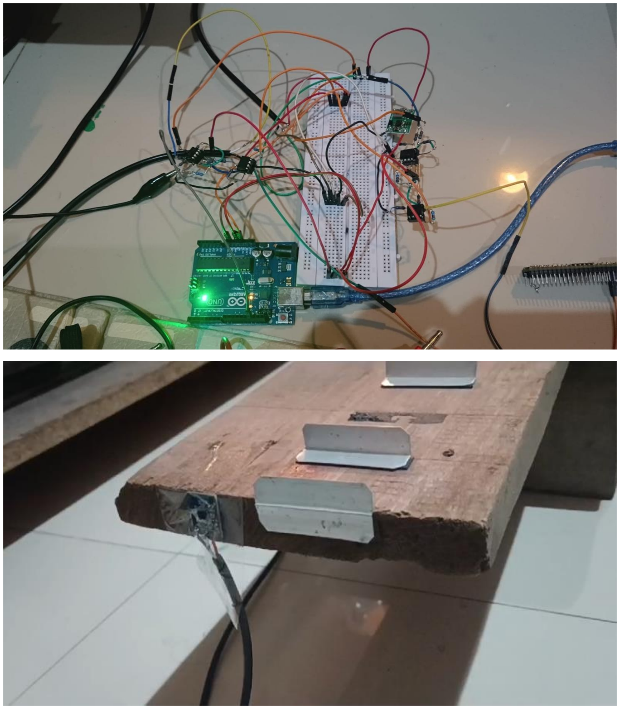
[picture p347: page 6]

### 1. Pukulan Sedang

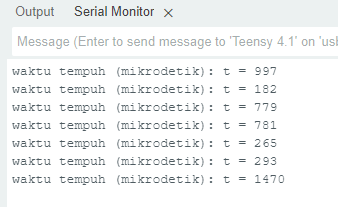
[picture p348: figure]

Hasil ToF tidak konsisten

### 2. Pukulan Keras Asal

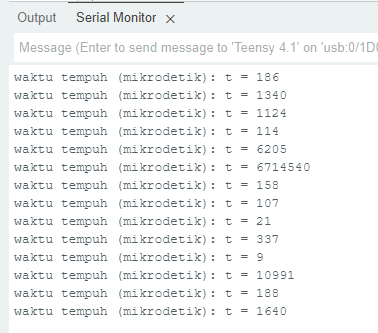
[picture p349: figure]

Hasil ToF tidak konsisten

SENSOR 2 | SENSOR 1 PIN Y GRAVITASI

### 3. Pukulan Ringan

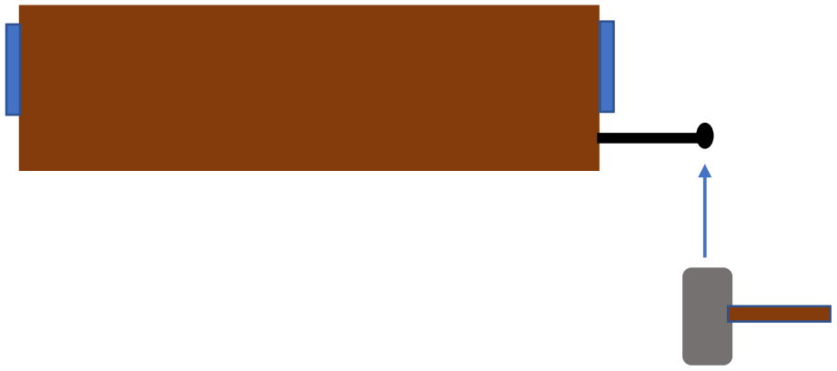
[picture p350: figure]
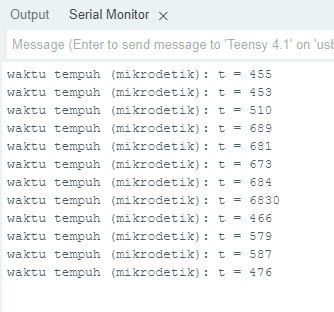
[picture p351: figure]

Rata2 t = 567 mikrosekon

L kayu = 0.90 meter

v = 1587 m/s

Sedikit konsisten namun hasil dari kecepatan tidak sesuai dengan teori. Seharusnya kecepatan akan berada pada rentang 3000-5000m/s ketika menggunakan media uji tsb.

PERCOBAAN 2

- Cek dan setting ulang tegangan di tiap output

Output Sensor → Diff Op Amp → Amplifier → Komparator

Riil:
Sensor 1
1.248 volt – 1.209 volt ≈ 0.081 volt * 20 ≈ 1,652 volt (diam) ketika dipukul < 2 volt → 0 Ketika dipukul > 12 volt → 1 Sensor 2
1.259 volt – 1.208 volt ≈ 0.096 volt * 20 ≈ 1,880 volt (diam) ketika dipukul < 2 volt → 0 Ketika dipukul > 2 volt → 1

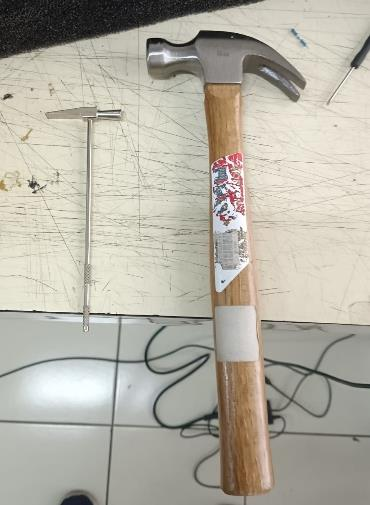
[picture p352: figure]

- Perbaikan jalur GND agar tidak terjadi riak noise
- Ganti palu dari yang semula besar menjadi kecil

Pukulan ringan palu kecil

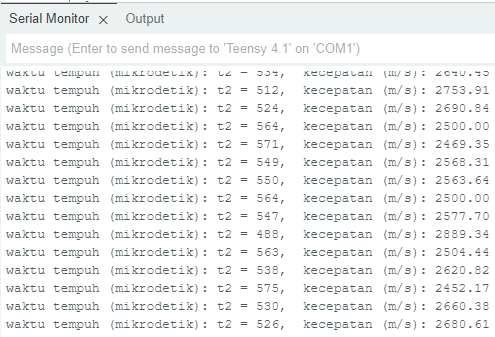
[picture p353: figure]

Sedikit konsisten namun hasil dari kecepatan masih belum sesuai dengan teori. Seharusnya kecepatan akan berada pada rentang 3000-5000m/s.

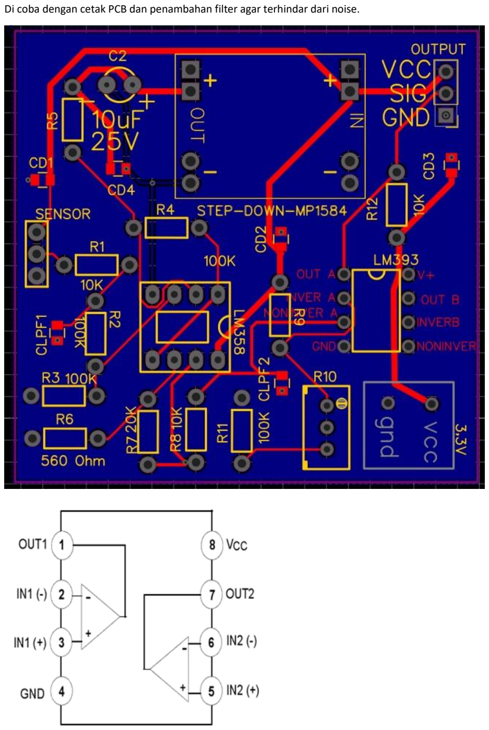
[picture p354: page 10]

Di coba dengan cetak PCB dan penambahan filter agar terhindar dari noise.

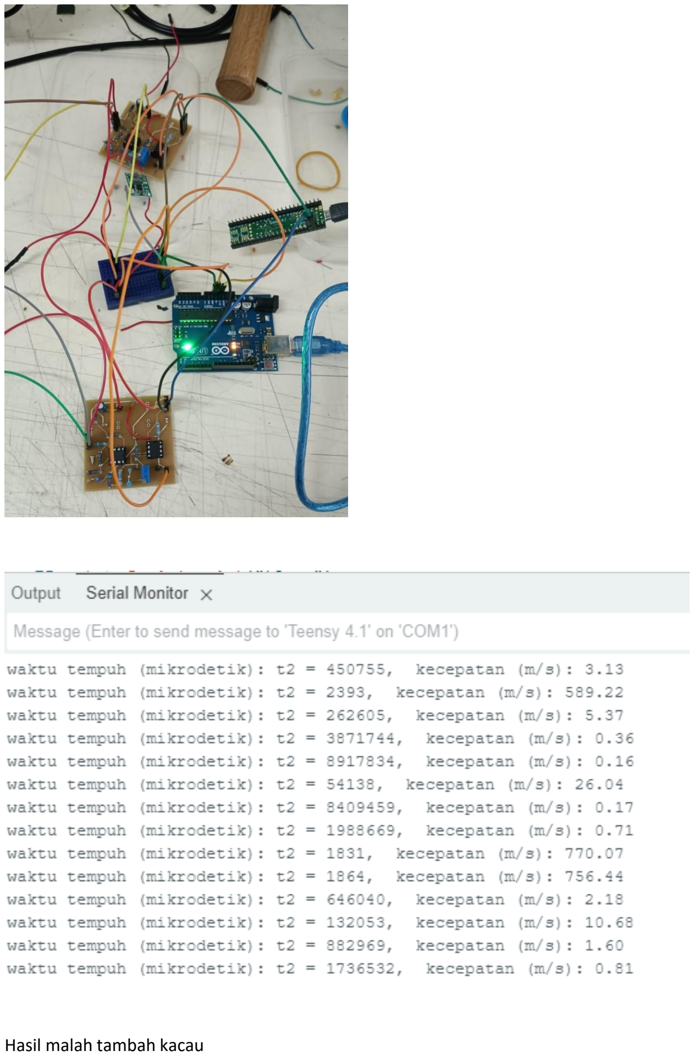
[picture p355: page 11]

Hasil malah tambah kacau

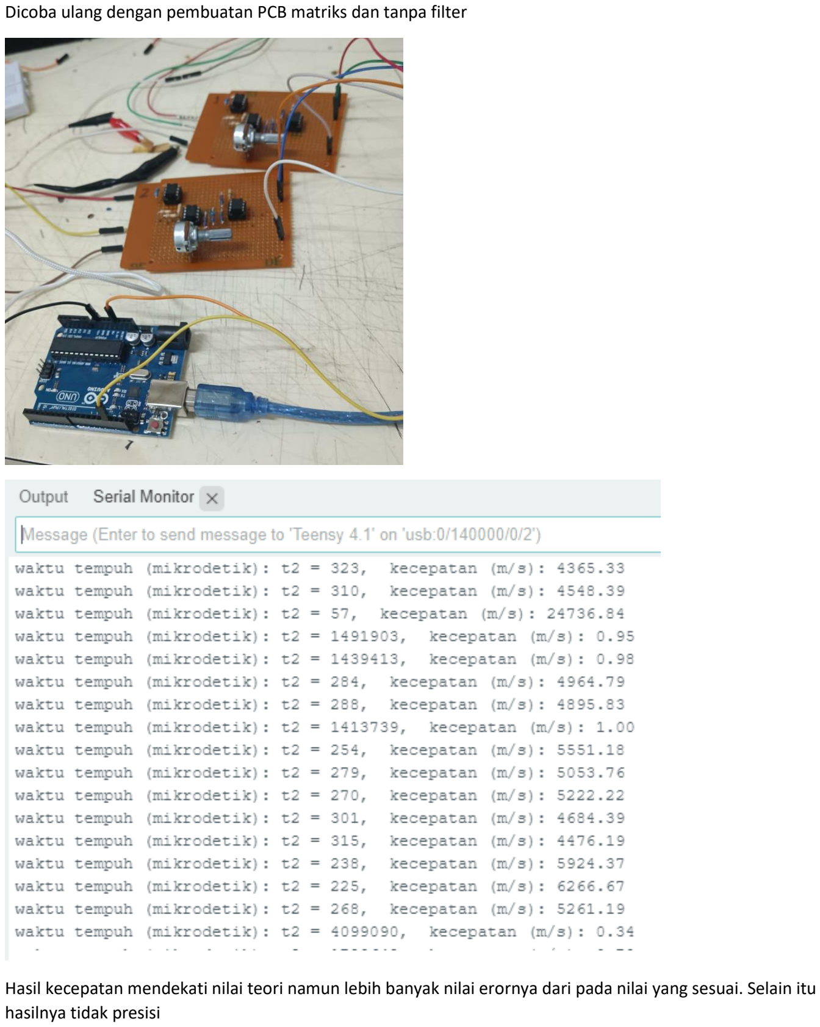
[picture p356: page 12]

Dicoba ulang dengan pembuatan PCB matriks dan tanpa filter

Hasil kecepatan mendekati nilai teori namun lebih banyak nilai erornya dari pada nilai yang sesuai. Selain itu hasilnya tidak presisi

PERCOBAAN 3

Hanya menggunakan komparator saja dan menghilangkan rangkaian diferensial amplifier serta operasional amplifier gain 20x.

Output Sensor → Diff Op Amp → Amplifier → Komparator

Output Sensor → Komparator

Tegangan saat diam (Sumbu Z):

S1 1.626 volt

S2 1.559 volt

Komparator:

Batas atas 1.7 volt

Batas bawah 1.5 volt

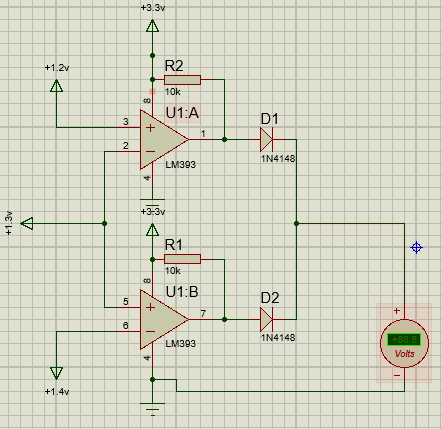
[picture p357: figure]
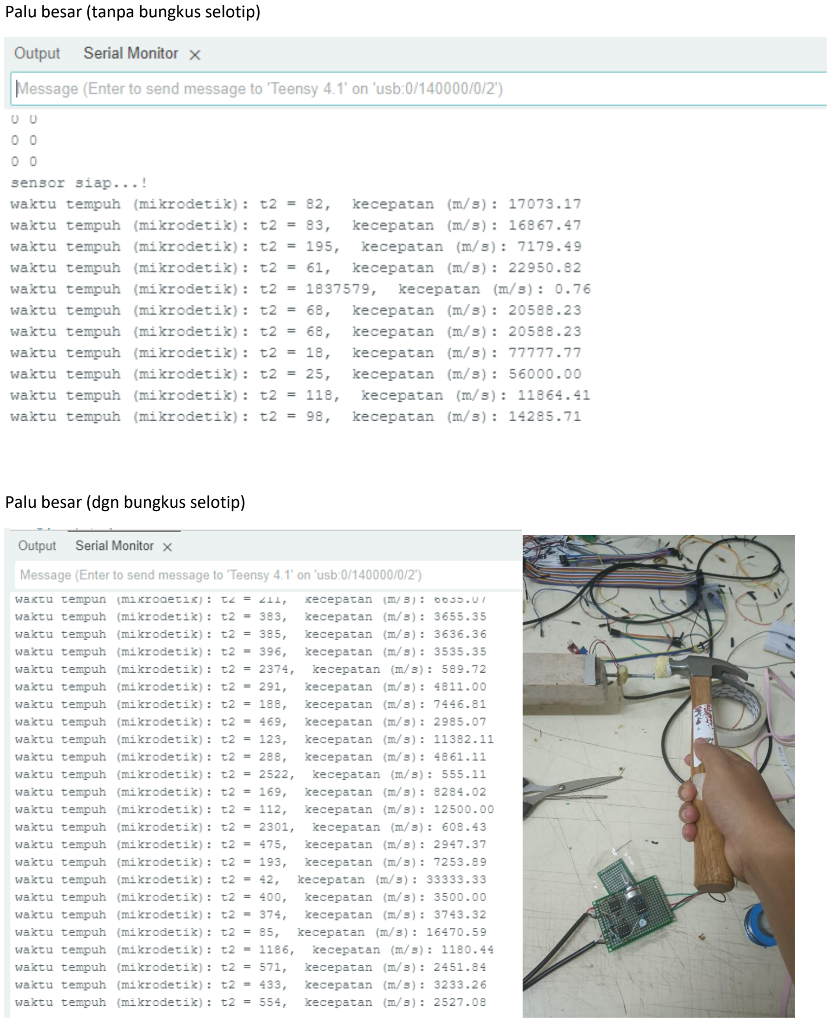
[picture p358: page 14]

Palu besar (tanpa bungkus selotip)

Palu besar (dgn bungkus selotip)

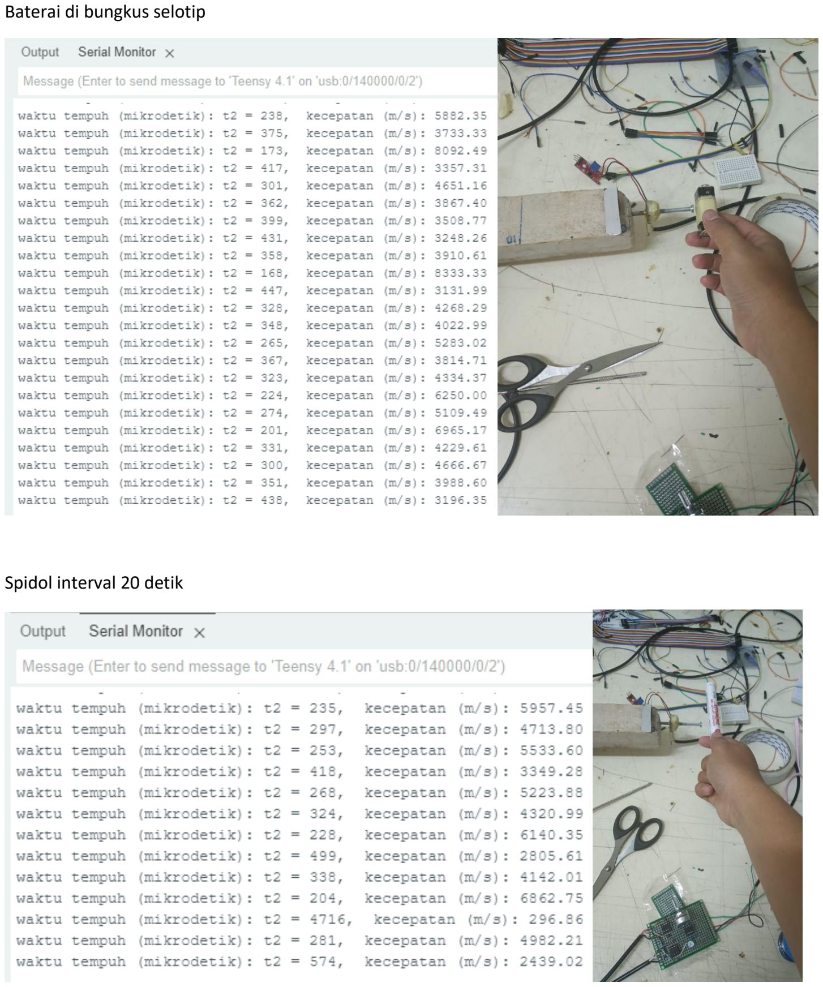
[picture p359: page 15]

Baterai di bungkus selotip

Spidol interval 20 detik

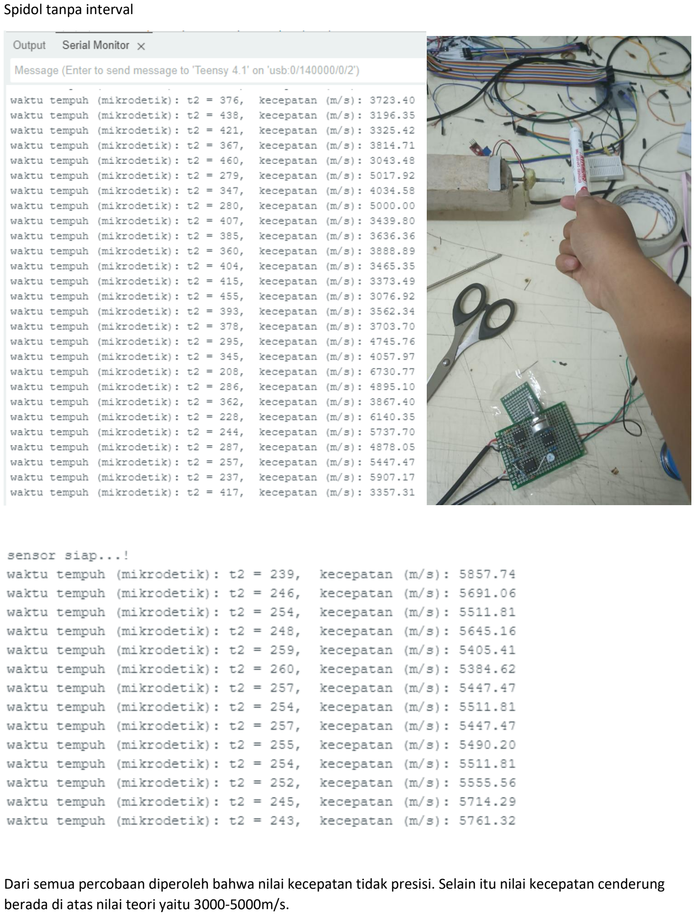
[picture p360: page 16]

Spidol tanpa interval

Dari semua percobaan diperoleh bahwa nilai kecepatan tidak presisi. Selain itu nilai kecepatan cenderung berada di atas nilai teori yaitu 3000-5000m/s.
