Akhmadi14/Terawang/Skematik desain/Schematic_PCB-Maiboard-Terakhir_2025-01-21.pdf

## Bluetooth HC05

BT1

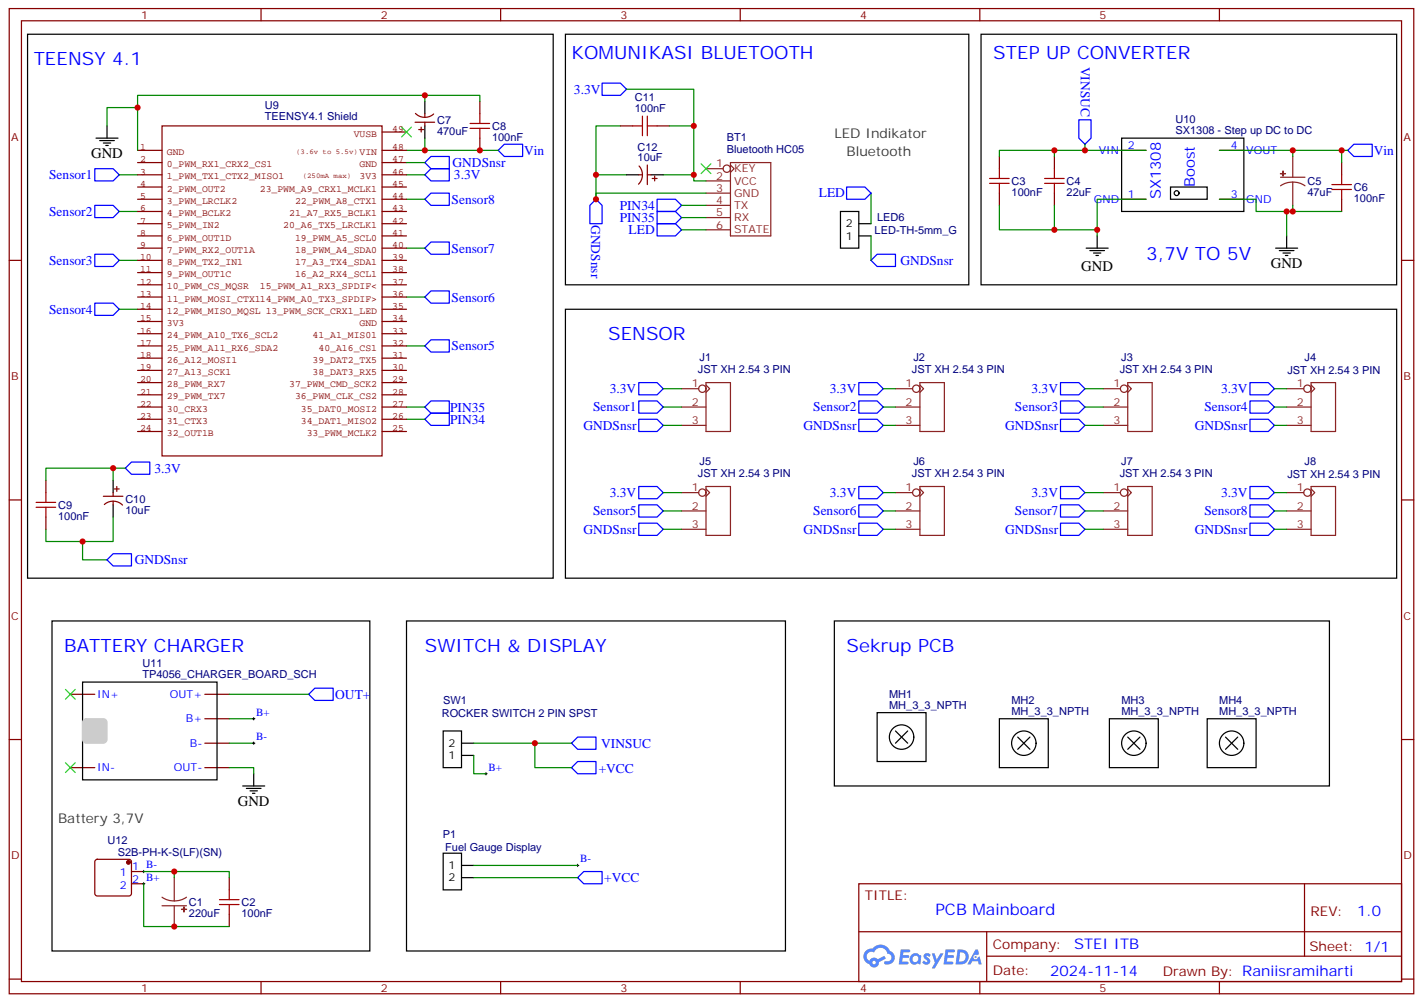
[picture p362: page 1]

SX1308 - Step up DC to DC

ROCKER SWITCH 2 PIN SPST
