Akhmadi14/Terawang/(commit log)

2025-01-18 Rename Perhitungan Kecepatan Ver2.pdf to velocity_calc2.pdf
2025-01-21 Add files via upload
    File mainboard berisi skematik PCB, gambar layer atas dan bawah PCB, serta file Gerber PCB
    [Drill_NPTH_Through.DRL, Drill_PTH_Through.DRL, Drill_PTH_Through_Via.DRL, Gerber_BoardOutlineLayer.GKO, Gerber_BottomLayer.GBL, Gerber_BottomSolderMaskLayer.GBS, Gerber_TopLayer.GTL, Gerber_TopPasteMaskLayer.GTP]
2025-01-23 Add files via upload
    berisikan file desain casing mainboard dalam format STL dan Solidwork, kemudian implementasi casing mainboard, dan modifikasi luggage box(koper alat)
    [casing utama_Revisi.SLDPRT, casing utama_Revisi.STL, penutup casing_Revisi.SLDPRT, penutup casing_Revisi.STL]
2025-01-23 Add files via upload
    Harga komponen dan material untuk hardware alat monitoring kondisi internal batang pohon (Terawang)
